RanFang66/SeekCytometer-vivado/constraints/debug_core.xdc

create_debug_core u_ila_0 ila
set_property ALL_PROBE_SAME_MU true [get_debug_cores u_ila_0]
set_property ALL_PROBE_SAME_MU_CNT 2 [get_debug_cores u_ila_0]
set_property C_ADV_TRIGGER false [get_debug_cores u_ila_0]
set_property C_DATA_DEPTH 4096 [get_debug_cores u_ila_0]
set_property C_EN_STRG_QUAL true [get_debug_cores u_ila_0]
set_property C_INPUT_PIPE_STAGES 0 [get_debug_cores u_ila_0]
set_property C_TRIGIN_EN false [get_debug_cores u_ila_0]
set_property C_TRIGOUT_EN false [get_debug_cores u_ila_0]
set_property port_width 1 [get_debug_ports u_ila_0/clk]
connect_debug_port u_ila_0/clk [get_nets [list cytometer_platform_i/zynq_ultra_ps_e_0/inst/pl_clk0]]
set_property PROBE_TYPE DATA_AND_TRIGGER [get_debug_ports u_ila_0/probe0]
set_property port_width 24 [get_debug_ports u_ila_0/probe0]
connect_debug_port u_ila_0/probe0 [get_nets [list {cytometer_platform_i/signal_analyzer_0/inst/signal_analyzer_v1_0_S00_AXI_inst/BASELINE_ESTIMATORS[1].baseline_estimator_inst/baseline[0]} {cytometer_platform_i/signal_analyzer_0/inst/signal_analyzer_v1_0_S00_AXI_inst/BASELINE_ESTIMATORS[1].baseline_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
create_debug_port u_ila_0 probe
set_property PROBE_TYPE DATA_AND_TRIGGER [get_debug_ports u_ila_0/probe1]
set_property port_width 18 [get_debug_ports u_ila_0/probe1]
connect_debug_port u_ila_0/probe1 [get_nets [list {cytometer_platform_i/signal_analyzer_0/inst/signal_analyzer_v1_0_S00_AXI_inst/BASELINE_ESTIMATORS[1].baseline_estimator_inst/baseline_out[0]} {cytometer_platform_i/signal_analyzer_0/inst/signal_analyzer_v1_0_S00_AXI_inst/BASELINE_ESTIMATORS[1].baseline_estimator_inst/baseline_out[1]} {cytometer_platform_i/signal_analyzer_0/inst/signal_analyzer_v1_0_S00_AXI_inst/BASELINE_ESTIMATORS[1].baseline_estimator_inst/baseline_out[2]} {cytometer_platform_i/signal_analyzer_0/inst/signal_analyzer_v1_0_S00_AXI_inst/BASELINE_ESTIMATORS[1].baseline_estimator_inst/baseline_out[3]} {cytometer_platform_i/signal_analyzer_0/inst/signal_analyzer_v1_0_S00_AXI_inst/BASELINE_ESTIMATORS[1].baseline_estimator_inst/baseline_out[4]} {cytometer_platform_i/signal_analyzer_0/inst/signal_analyzer_v1_0_S00_AXI_inst/BASELINE_ESTIMATORS[1].baseline_estimator_inst/baseline_out[5]} {cytometer_platform_i/signal_analyzer_0/inst/signal_analyzer_v1_0_S00_AXI_inst/BASELINE_ESTIMATORS[1].baseline_estimator_inst/baseline_out[6]} {cytometer_platform_i/signal_analyzer_0/inst/signal_analyzer_v1_0_S00_AXI_inst/BASELINE_ESTIMATORS[1].baseline_estimator_inst/baseline_out[7]} {cytometer_platform_i/signal_analyzer_0/inst/signal_analyzer_v1_0_S00_AXI_inst/BASELINE_ESTIMATORS[1].baseline_estimator_inst/baseline_out[8]} {cytometer_platform_i/signal_analyzer_0/inst/signal_analyzer_v1_0_S00_AXI_inst/BASELINE_ESTIMATORS[1].baseline_estimator_inst/baseline_out[9]} {cytometer_platform_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
nst/signal_analyzer_v1_0_S00_AXI_inst/BASELINE_ESTIMATORS[1].baseline_estimator_inst/err_reg[21]} {cytometer_platform_i/signal_analyzer_0/inst/signal_analyzer_v1_0_S00_AXI_inst/BASELINE_ESTIMATORS[1].baseline_estimator_inst/err_reg[22]} {cytometer_platform_i/signal_analyzer_0/inst/signal_analyzer_v1_0_S00_AXI_inst/BASELINE_ESTIMATORS[1].baseline_estimator_inst/err_reg[23]} {cytometer_platform_i/signal_analyzer_0/inst/signal_analyzer_v1_0_S00_AXI_inst/BASELINE_ESTIMATORS[1].baseline_estimator_inst/err_reg[24]}]]
create_debug_port u_ila_0 probe
set_property PROBE_TYPE DATA_AND_TRIGGER [get_debug_ports u_ila_0/probe3]
set_property port_width 18 [get_debug_ports u_ila_0/probe3]
connect_debug_port u_ila_0/probe3 [get_nets [list {cytometer_platform_i/signal_analyzer_0/inst/signal_analyzer_v1_0_S00_AXI_inst/BASELINE_ESTIMATORS[1].baseline_estimator_inst/sample_in[0]} {cytometer_platform_i/signal_analyzer_0/inst/signal_analyzer_v1_0_S00_AXI_inst/BASELINE_ESTIMATORS[1].baseline_estimator_inst/sample_in[1]} {cytometer_platform_i/signal_analyzer_0/inst/signal_analyzer_v1_0_S00_AXI_inst/BASELINE_ESTIMATORS[1].baseline_estimator_inst/sample_in[2]} {cytometer_platform_i/signal_analyzer_0/inst/signal_analyzer_v1_0_S00_AXI_inst/BASELINE_ESTIMATORS[1].baseline_estimator_inst/sample_in[3]} {cytometer_platform_i/signal_analyzer_0/inst/signal_analyzer_v1_0_S00_AXI_inst/BASELINE_ESTIMATORS[1].baseline_estimator_inst/sample_in[4]} {cytometer_platform_i/signal_analyzer_0/inst/signal_analyzer_v1_0_S00_AXI_inst/BASELINE_ESTIMATORS[1].baseline_estimator_inst/sample_in[5]} {cytometer_platform_i/signal_analyzer_0/inst/signal_analyzer_v1_0_S00_AXI_inst/BASELINE_ESTIMATORS[1].baseline_estimator_inst/sample_in[6]} {cytometer_platform_i/signal_analyzer_0/inst/signal_analyzer_v1_0_S00_AXI_inst/BASELINE_ESTIMATORS[1].baseline_estimator_inst/sample_in[7]} {cytometer_platform_i/signal_analyzer_0/inst/signal_analyzer_v1_0_S00_AXI_inst/BASELINE_ESTIMATORS[1].baseline_estimator_inst/sample_in[8]} {cytometer_platform_i/signal_analyzer_0/inst/signal_analyzer_v1_0_S00_AXI_inst/BASELINE_ESTIMATORS[1].baseline_estimator_inst/sample_in[9]} {cytometer_platform_i/signal_analyzer_0/inst/signa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
i/signal_analyzer_0/inst/signal_analyzer_v1_0_S00_AXI_inst/BASELINE_ESTIMATORS[3].baseline_estimator_inst/baseline[21]} {cytometer_platform_i/signal_analyzer_0/inst/signal_analyzer_v1_0_S00_AXI_inst/BASELINE_ESTIMATORS[3].baseline_estimator_inst/baseline[22]} {cytometer_platform_i/signal_analyzer_0/inst/signal_analyzer_v1_0_S00_AXI_inst/BASELINE_ESTIMATORS[3].baseline_estimator_inst/baseline[23]}]]
create_debug_port u_ila_0 probe
set_property PROBE_TYPE DATA_AND_TRIGGER [get_debug_ports u_ila_0/probe6]
set_property port_width 25 [get_debug_ports u_ila_0/probe6]
connect_debug_port u_ila_0/probe6 [get_nets [list {cytometer_platform_i/signal_analyzer_0/inst/signal_analyzer_v1_0_S00_AXI_inst/BASELINE_ESTIMATORS[3].baseline_estimator_inst/err_reg[0]} {cytometer_platform_i/signal_analyzer_0/inst/signal_analyzer_v1_0_S00_AXI_inst/BASELINE_ESTIMATORS[3].baseline_e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
create_debug_port u_ila_0 probe
set_property PROBE_TYPE DATA_AND_TRIGGER [get_debug_ports u_ila_0/probe7]
set_property port_width 18 [get_debug_ports u_ila_0/probe7]
connect_debug_port u_ila_0/probe7 [get_nets [list {cytometer_platform_i/signal_analyzer_0/inst/signal_analyzer_v1_0_S00_AXI_inst/BASELINE_ESTIMATORS[3].baseline_estimator_inst/sample_in[0]} {cytometer_platform_i/signal_analyzer_0/inst/signal_analyzer_v1_0_S00_AXI_inst/BASELINE_ESTIMATORS[3].baseline_estimator_inst/sample_in[1]} {cytometer_platform_i/signal_analyzer_0/inst/signal_analyzer_v1_0_S00_AXI_inst/BASELINE_ESTIMATORS[3].baseline_estimator_inst/sample_in[2]} {cytometer_platform_i/signal_analyzer_0/inst/signal_analyzer_v1_0_S00_AXI_inst/BASELINE_ESTIMATORS[3].baseline_estimator_inst/sample_in[3]} {cytometer_platform_i/signal_analyzer_0/inst/signal_analyzer_v1_0_S00_AXI_inst/BASELINE_ESTIMATORS[3].baseline_estimator_inst/sample_in[4]} {cytometer_platform_i/signal_analyzer_0/inst/signal_analyzer_v1_0_S00_AXI_inst/BASELINE_ESTIMATORS[3].baseline_estimator_inst/sample_in[5]} {cytometer_platform_i/signal_analyzer_0/inst/signal_analyzer_v1_0_S00_AXI_inst/BASELINE_ESTIMATORS[3].baseline_estimator_inst/sample_in[6]} {cytometer_platform_i/signal_analyzer_0/inst/signal_analyzer_v1_0_S00_AXI_inst/BASELINE_ESTIMATORS[3].baseline_estimator_inst/sample_in[7]} {cytometer_platform_i/signal_analyzer_0/inst/signal_analyzer_v1_0_S00_AXI_inst/BASELINE_ESTIMATORS[3].baseline_estimator_inst/sample_in[8]} {cytometer_platform_i/signal_analyzer_0/inst/signal_analyzer_v1_0_S00_AXI_inst/BASELINE_ESTIMATORS[3].baseline_estimator_inst/sample_in[9]} {cytometer_platform_i/signal_analyzer_0/inst/signa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
nst/signal_analyzer_v1_0_S00_AXI_inst/BASELINE_ESTIMATORS[2].baseline_estimator_inst/err_reg[21]} {cytometer_platform_i/signal_analyzer_0/inst/signal_analyzer_v1_0_S00_AXI_inst/BASELINE_ESTIMATORS[2].baseline_estimator_inst/err_reg[22]} {cytometer_platform_i/signal_analyzer_0/inst/signal_analyzer_v1_0_S00_AXI_inst/BASELINE_ESTIMATORS[2].baseline_estimator_inst/err_reg[23]} {cytometer_platform_i/signal_analyzer_0/inst/signal_analyzer_v1_0_S00_AXI_inst/BASELINE_ESTIMATORS[2].baseline_estimator_inst/err_reg[24]}]]
create_debug_port u_ila_0 probe
set_property PROBE_TYPE DATA_AND_TRIGGER [get_debug_ports u_ila_0/probe9]
set_property port_width 24 [get_debug_ports u_ila_0/probe9]
connect_debug_port u_ila_0/probe9 [get_nets [list {cytometer_platform_i/signal_analyzer_0/inst/signal_analyzer_v1_0_S00_AXI_inst/BASELINE_ESTIMATORS[2].baseline_estimator_inst/baseline[0]} {cytometer_platform_i/signal_analyzer_0/inst/signal_analyzer_v1_0_S00_AXI_inst/BASELINE_ESTIMATORS[2].baseline_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
create_debug_port u_ila_0 probe
set_property PROBE_TYPE DATA_AND_TRIGGER [get_debug_ports u_ila_0/probe10]
set_property port_width 18 [get_debug_ports u_ila_0/probe10]
connect_debug_port u_ila_0/probe10 [get_nets [list {cytometer_platform_i/signal_analyzer_0/inst/signal_analyzer_v1_0_S00_AXI_inst/BASELINE_ESTIMATORS[2].baseline_estimator_inst/sample_in[0]} {cytometer_platform_i/signal_analyzer_0/inst/signal_analyzer_v1_0_S00_AXI_inst/BASELINE_ESTIMATORS[2].baseline_estimator_inst/sample_in[1]} {cytometer_platform_i/signal_analyzer_0/inst/signal_analyzer_v1_0_S00_AXI_inst/BASELINE_ESTIMATORS[2].baseline_estimator_inst/sample_in[2]} {cytometer_platform_i/signal_analyzer_0/inst/signal_analyzer_v1_0_S00_AXI_inst/BASELINE_ESTIMATORS[2].baseline_estimator_inst/sample_in[3]} {cytometer_platform_i/signal_analyzer_0/inst/signal_analyzer_v1_0_S00_AXI_inst/BASELINE_ESTIMATORS[2].baseline_estimator_inst/sample_in[4]} {cytometer_platform_i/signal_analyzer_0/inst/signal_analyzer_v1_0_S00_AXI_inst/BASELINE_ESTIMATORS[2].baseline_estimator_inst/sample_in[5]} {cytometer_platform_i/signal_analyzer_0/inst/signal_analyzer_v1_0_S00_AXI_inst/BASELINE_ESTIMATORS[2].baseline_estimator_inst/sample_in[6]} {cytometer_platform_i/signal_analyzer_0/inst/signal_analyzer_v1_0_S00_AXI_inst/BASELINE_ESTIMATORS[2].baseline_estimator_inst/sample_in[7]} {cytometer_platform_i/signal_analyzer_0/inst/signal_analyzer_v1_0_S00_AXI_inst/BASELINE_ESTIMATORS[2].baseline_estimator_inst/sample_in[8]} {cytometer_platform_i/signal_analyzer_0/inst/signal_analyzer_v1_0_S00_AXI_inst/BASELINE_ESTIMATORS[2].baseline_estimator_inst/sample_in[9]} {cytometer_platform_i/signal_analyzer_0/inst/sign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
inst/signal_analyzer_v1_0_S00_AXI_inst/BASELINE_ESTIMATORS[0].baseline_estimator_inst/err_reg[21]} {cytometer_platform_i/signal_analyzer_0/inst/signal_analyzer_v1_0_S00_AXI_inst/BASELINE_ESTIMATORS[0].baseline_estimator_inst/err_reg[22]} {cytometer_platform_i/signal_analyzer_0/inst/signal_analyzer_v1_0_S00_AXI_inst/BASELINE_ESTIMATORS[0].baseline_estimator_inst/err_reg[23]} {cytometer_platform_i/signal_analyzer_0/inst/signal_analyzer_v1_0_S00_AXI_inst/BASELINE_ESTIMATORS[0].baseline_estimator_inst/err_reg[24]}]]
create_debug_port u_ila_0 probe
set_property PROBE_TYPE DATA_AND_TRIGGER [get_debug_ports u_ila_0/probe15]
set_property port_width 24 [get_debug_ports u_ila_0/probe15]
connect_debug_port u_ila_0/probe15 [get_nets [list {cytometer_platform_i/signal_analyzer_0/inst/signal_analyzer_v1_0_S00_AXI_inst/BASELINE_ESTIMATORS[0].baseline_estimator_inst/baseline[0]} {cytometer_platform_i/signal_analyzer_0/inst/signal_analyzer_v1_0_S00_AXI_inst/BASELINE_ESTIMATORS[0].baseline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
create_debug_port u_ila_0 probe
set_property PROBE_TYPE DATA_AND_TRIGGER [get_debug_ports u_ila_0/probe16]
set_property port_width 1 [get_debug_ports u_ila_0/probe16]
connect_debug_port u_ila_0/probe16 [get_nets [list {cytometer_platform_i/signal_analyzer_0/inst/signal_analyzer_v1_0_S00_AXI_inst/BASELINE_ESTIMATORS[1].baseline_estimator_inst/baseline_valid}]]
create_debug_port u_ila_0 probe
set_property PROBE_TYPE DATA_AND_TRIGGER [get_debug_ports u_ila_0/probe17]
set_property port_width 1 [get_debug_ports u_ila_0/probe17]
connect_debug_port u_ila_0/probe17 [get_nets [list {cytometer_platform_i/signal_analyzer_0/inst/signal_analyzer_v1_0_S00_AXI_inst/BASELINE_ESTIMATORS[0].baseline_estimator_inst/baseline_valid}]]
create_debug_port u_ila_0 probe
set_property PROBE_TYPE DATA_AND_TRIGGER [get_debug_ports u_ila_0/probe18]
set_property port_width 1 [get_debug_ports u_ila_0/probe18]
connect_debug_port u_ila_0/probe18 [get_nets [list {cytometer_platform_i/signal_analyzer_0/inst/signal_analyzer_v1_0_S00_AXI_inst/BASELINE_ESTIMATORS[2].baseline_estimator_inst/baseline_valid}]]
create_debug_port u_ila_0 probe
set_property PROBE_TYPE DATA_AND_TRIGGER [get_debug_ports u_ila_0/probe19]
set_property port_width 1 [get_debug_ports u_ila_0/probe19]
connect_debug_port u_ila_0/probe19 [get_nets [list {cytometer_platform_i/signal_analyzer_0/inst/signal_analyzer_v1_0_S00_AXI_inst/BASELINE_ESTIMATORS[3].baseline_estimator_inst/baseline_valid}]]
create_debug_port u_ila_0 probe
set_property PROBE_TYPE DATA_AND_TRIGGER [get_debug_ports u_ila_0/probe20]
set_property port_width 1 [get_debug_ports u_ila_0/probe20]
connect_debug_port u_ila_0/probe20 [get_nets [list {cytometer_platform_i/signal_analyzer_0/inst/signal_analyzer_v1_0_S00_AXI_inst/BASELINE_ESTIMATORS[0].baseline_estimator_inst/pulse_active}]]
create_debug_port u_ila_0 probe
set_property PROBE_TYPE DATA_AND_TRIGGER [get_debug_ports u_ila_0/probe21]
set_property port_width 1 [get_debug_ports u_ila_0/probe21]
connect_debug_port u_ila_0/probe21 [get_nets [list {cytometer_platform_i/signal_analyzer_0/inst/signal_analyzer_v1_0_S00_AXI_inst/BASELINE_ESTIMATORS[2].baseline_estimator_inst/pulse_active}]]
create_debug_port u_ila_0 probe
set_property PROBE_TYPE DATA_AND_TRIGGER [get_debug_ports u_ila_0/probe22]
set_property port_width 1 [get_debug_ports u_ila_0/probe22]
connect_debug_port u_ila_0/probe22 [get_nets [list {cytometer_platform_i/signal_analyzer_0/inst/signal_analyzer_v1_0_S00_AXI_inst/BASELINE_ESTIMATORS[1].baseline_estimator_inst/pulse_active}]]
create_debug_port u_ila_0 probe
set_property PROBE_TYPE DATA_AND_TRIGGER [get_debug_ports u_ila_0/probe23]
set_property port_width 1 [get_debug_ports u_ila_0/probe23]
connect_debug_port u_ila_0/probe23 [get_nets [list {cytometer_platform_i/signal_analyzer_0/inst/signal_analyzer_v1_0_S00_AXI_inst/BASELINE_ESTIMATORS[3].baseline_estimator_inst/pulse_active}]]
create_debug_port u_ila_0 probe
set_property PROBE_TYPE DATA_AND_TRIGGER [get_debug_ports u_ila_0/probe24]
set_property port_width 1 [get_debug_ports u_ila_0/probe24]
connect_debug_port u_ila_0/probe24 [get_nets [list {cytometer_platform_i/signal_analyzer_0/inst/signal_analyzer_v1_0_S00_AXI_inst/PULSE_ANALYZERS[3].pulse_analyzer_inst/sample_valid}]]
create_debug_port u_ila_0 probe
set_property PROBE_TYPE DATA_AND_TRIGGER [get_debug_ports u_ila_0/probe25]
set_property port_width 1 [get_debug_ports u_ila_0/probe25]
connect_debug_port u_ila_0/probe25 [get_nets [list {cytometer_platform_i/signal_analyzer_0/inst/signal_analyzer_v1_0_S00_AXI_inst/PULSE_ANALYZERS[0].pulse_analyzer_inst/sample_valid}]]
create_debug_port u_ila_0 probe
set_property PROBE_TYPE DATA_AND_TRIGGER [get_debug_ports u_ila_0/probe26]
set_property port_width 1 [get_debug_ports u_ila_0/probe26]
connect_debug_port u_ila_0/probe26 [get_nets [list {cytometer_platform_i/signal_analyzer_0/inst/signal_analyzer_v1_0_S00_AXI_inst/PULSE_ANALYZERS[1].pulse_analyzer_inst/sample_valid}]]
create_debug_port u_ila_0 probe
set_property PROBE_TYPE DATA_AND_TRIGGER [get_debug_ports u_ila_0/probe27]
set_property port_width 1 [get_debug_ports u_ila_0/probe27]
connect_debug_port u_ila_0/probe27 [get_nets [list {cytometer_platform_i/signal_analyzer_0/inst/signal_analyzer_v1_0_S00_AXI_inst/PULSE_ANALYZERS[2].pulse_analyzer_inst/sample_valid}]]
create_debug_port u_ila_0 probe
set_property PROBE_TYPE DATA_AND_TRIGGER [get_debug_ports u_ila_0/probe28]
set_property port_width 1 [get_debug_ports u_ila_0/probe28]
connect_debug_port u_ila_0/probe28 [get_nets [list {cytometer_platform_i/signal_analyzer_0/inst/signal_analyzer_v1_0_S00_AXI_inst/BASELINE_ESTIMATORS[3].baseline_estimator_inst/state}]]
create_debug_port u_ila_0 probe
set_property PROBE_TYPE DATA_AND_TRIGGER [get_debug_ports u_ila_0/probe29]
set_property port_width 1 [get_debug_ports u_ila_0/probe29]
connect_debug_port u_ila_0/probe29 [get_nets [list {cytometer_platform_i/signal_analyzer_0/inst/signal_analyzer_v1_0_S00_AXI_inst/BASELINE_ESTIMATORS[1].baseline_estimator_inst/state}]]
create_debug_port u_ila_0 probe
set_property PROBE_TYPE DATA_AND_TRIGGER [get_debug_ports u_ila_0/probe30]
set_property port_width 1 [get_debug_ports u_ila_0/probe30]
connect_debug_port u_ila_0/probe30 [get_nets [list {cytometer_platform_i/signal_analyzer_0/inst/signal_analyzer_v1_0_S00_AXI_inst/BASELINE_ESTIMATORS[0].baseline_estimator_inst/state}]]
create_debug_port u_ila_0 probe
set_property PROBE_TYPE DATA_AND_TRIGGER [get_debug_ports u_ila_0/probe31]
set_property port_width 1 [get_debug_ports u_ila_0/probe31]
connect_debug_port u_ila_0/probe31 [get_nets [list {cytometer_platform_i/signal_analyzer_0/inst/signal_analyzer_v1_0_S00_AXI_inst/BASELINE_ESTIMATORS[2].baseline_estimator_inst/state}]]
set_property C_CLK_INPUT_FREQ_HZ 300000000 [get_debug_cores dbg_hub]
set_property C_ENABLE_CLK_DIVIDER false [get_debug_cores dbg_hub]
set_property C_USER_SCAN_CHAIN 1 [get_debug_cores dbg_hub]
connect_debug_port dbg_hub/clk [get_nets u_ila_0_pl_clk0]
