RanFang66/SeekCytometer-vivado/ip_repo/signal_analyzer_1_0/hdl/signal_analyzer_v1_0_S00_AXI.v

`timescale 1 ns / 1 ps

	module signal_analyzer_v1_0_S00_AXI #
	(
		// Users to add parameters here
        parameter integer  C_AD_DATA_DEPTH = 18,
        parameter integer  C_AD_CHANNEL_NUM = 8,
		// User parameters ends
		// Do not modify the parameters beyond this line

		// Width of S_AXI data bus
		parameter integer C_S_AXI_DATA_WIDTH	= 32,
		// Width of S_AXI address bus
		parameter integer C_S_AXI_ADDR_WIDTH	= 8
	)
	(
		// Users to add ports here
		input wire ad_data_valid,
        input wire [C_AD_DATA_DEPTH-1:0] ad_ch1_val,
        input wire [C_AD_DATA_DEPTH-1:0] ad_ch2_val,
        input wire [C_AD_DATA_DEPTH-1:0] ad_ch3_val,
        input wire [C_AD_DATA_DEPTH-1:0] ad_ch4_val,
        input wire [C_AD_DATA_DEPTH-1:0] ad_ch5_val,
        input wire [C_AD_DATA_DEPTH-1:0] ad_ch6_val,
        input wire [C_AD_DATA_DEPTH-1:0] ad_ch7_val,
        input wire [C_AD_DATA_DEPTH-1:0] ad_ch8_val,
        
        output wire event_active,
		output wire [C_AD_CHANNEL_NUM-1:0] channel_active,
		output wire event_done,
		output wire [2:0] drive_state_out,
		output wire drive_level_out,

		output wire [31:0] bram_din_a, // Data to write to BRAM
		output wire [31:0] bram_addr_a, // Address in BRAM
		output wire bram_we_a, // Write enable for BRAM
		output wire bram_en_a, // Enable signal for BRAM

        output wire [31:0] bram_din_b,        // Data to write to BRAM
		output wire [31:0] bram_addr_b, // Address in BRAM
		output wire [3:0] bram_we_b,            // Write enable for BRAM
		output wire bram_en_b,            // Enable signal for BRAM
		input  wire [31:0] bram_dout_b,       // Data read from BRAM, not used in this module
		output wire bram_rst_b,          // Reset signal for BRAM
		output wire bram_clk_b,          // Clock signal for BRAM

		// User ports ends
		// Do not modify the ports beyond this line

		// Global Clock Signal
		input wire  S_AXI_ACLK,
		// Global Reset Signal. This Signal is Active LOW
		input wire  S_AXI_ARESETN,
		// Write address (issued by master, acceped by Slave)
		input wire [C_S_AXI_ADDR_WIDTH-1 : 0] S_AXI_AWADDR,
		// Write channel Protection type. This signal indicates the
    		// privilege and security level of the transaction, and whether
    		// the transaction is a data access or an instruction access.
		input wire [2 : 0] S_AXI_AWPROT,
		// Write address valid. This signal indicates that the master signaling
    		// valid write address and control information.
		input wire  S_AXI_AWVALID,
		// Write address ready. This signal indicates that the slave is ready
    		// to accept an address and associated control signals.
		output wire  S_AXI_AWREADY,
		// Write data (issued by master, acceped by Slave) 
		input wire [C_S_AXI_DATA_WIDTH-1 : 0] S_AXI_WDATA,
		// Write strobes. This signal indicates which byte lanes hold
    		// valid data. There is one write strobe bit for each eight
    		// bits of the write data bus.    
		input wire [(C_S_AXI_DATA_WIDTH/8)-1 : 0] S_AXI_WSTRB,
		// Write valid. This signal indicates that valid write
    		// data and strobes are available.
		input wire  S_AXI_WVALID,
		// Write ready. This signal indicates that the slave
    		// can accept the write data.
		output wire  S_AXI_WREADY,
		// Write response. This signal indicates the status
    		// of the write transaction.
		output wire [1 : 0] S_AXI_BRESP,
		// Write response valid. This signal indicates that the channel
    		// is signaling a valid write response.
		output wire  S_AXI_BVALID,
		// Response ready. This signal indicates that the master
    		// can accept a write response.
		input wire  S_AXI_BREADY,
		// Read address (issued by master, acceped by Slave)
		input wire [C_S_AXI_ADDR_WIDTH-1 : 0] S_AXI_ARADDR,
		// Protection type. This signal indicates the privilege
    		// and security level of the transaction, and whether the
    		// transaction is a data access or an instruction access.
		input wire [2 : 0] S_AXI_ARPROT,
		// Read address valid. This signal indicates that the channel
    		// is signaling valid read address and control information.
		input wire  S_AXI_ARVALID,
		// Read address ready. This signal indicates that the slave is
    		// ready to accept an address and associated control signals.
		output wire  S_AXI_ARREADY,
		// Read data (issued by slave)
		output wire [C_S_AXI_DATA_WIDTH-1 : 0] S_AXI_RDATA,
		// Read response. This signal indicates the status of the
    		// read transfer.
		output wire [1 : 0] S_AXI_RRESP,
		// Read valid. This signal indicates that the channel is
    		// signaling the required read data.
		output wire  S_AXI_RVALID,
		// Read ready. This signal indicates that the master can
    		// accept the read data and response information.
		input wire  S_AXI_RREADY
	);
    
   
        



	// AXI4LITE signals
	reg [C_S_AXI_ADDR_WIDTH-1 : 0] 	axi_awaddr;
	reg  	axi_awready;
	reg  	axi_wready;
	reg [1 : 0] 	axi_bresp;
	reg  	axi_bvalid;
	reg [C_S_AXI_ADDR_WIDTH-1 : 0] 	axi_araddr;
	reg  	axi_arready;
	reg [C_S_AXI_DATA_WIDTH-1 : 0] 	axi_rdata;
	reg [1 : 0] 	axi_rresp;
	reg  	axi_rvalid;

	// Example-specific design signals
	// local parameter for addressing 32 bit / 64 bit C_S_AXI_DATA_WIDTH
	// ADDR_LSB is used for addressing 32/64 bit registers/memories
	// ADDR_LSB = 2 for 32 bits (n downto 2)
	// ADDR_LSB = 3 for 64 bits (n downto 3)
	localparam integer ADDR_LSB = (C_S_AXI_DATA_WIDTH/32) + 1;
	localparam integer OPT_MEM_ADDR_BITS = 5;
	//----------------------------------------------
	//-- Signals for user logic register space example
	//------------------------------------------------
	//-- Number of Slave Registers 64
	reg [C_S_AXI_DATA_WIDTH-1:0]	slv_reg0;
	reg [C_S_AXI_DATA_WIDTH-1:0]	slv_reg1;
	reg [C_S_AXI_DATA_WIDTH-1:0]	slv_reg2;
	reg [C_S_AXI_DATA_WIDTH-1:0]	slv_reg3;
	reg [C_S_AXI_DATA_WIDTH-1:0]	slv_reg4;
	reg [C_S_AXI_DATA_WIDTH-1:0]	slv_reg5;
	reg [C_S_AXI_DATA_WIDTH-1:0]	slv_reg6;
	reg [C_S_AXI_DATA_WIDTH-1:0]	slv_reg7;
	reg [C_S_AXI_DATA_WIDTH-1:0]	slv_reg8;
	reg [C_S_AXI_DATA_WIDTH-1:0]	slv_reg9;
	reg [C_S_AXI_DATA_WIDTH-1:0]	slv_reg10;
	reg [C_S_AXI_DATA_WIDTH-1:0]	slv_reg11;
	reg [C_S_AXI_DATA_WIDTH-1:0]	slv_reg12;
	reg [C_S_AXI_DATA_WIDTH-1:0]	slv_reg13;
	reg [C_S_AXI_DATA_WIDTH-1:0]	slv_reg14;
	reg [C_S_AXI_DATA_WIDTH-1:0]	slv_reg15;
	reg [C_S_AXI_DATA_WIDTH-1:0]	slv_reg16;
	reg [C_S_AXI_DATA_WIDTH-1:0]	slv_reg17;
	reg [C_S_AXI_DATA_WIDTH-1:0]	slv_reg18;
	reg [C_S_AXI_DATA_WIDTH-1:0]	slv_reg19;
	reg [C_S_AXI_DATA_WIDTH-1:0]	slv_reg20;
	reg [C_S_AXI_DATA_WIDTH-1:0]	slv_reg21;
	reg [C_S_AXI_DATA_WIDTH-1:0]	slv_reg22;
	reg [C_S_AXI_DATA_WIDTH-1:0]	slv_reg23;
	reg [C_S_AXI_DATA_WIDTH-1:0]	slv_reg24;
	reg [C_S_AXI_DATA_WIDTH-1:0]	slv_reg25;
	reg [C_S_AXI_DATA_WIDTH-1:0]	slv_reg26;
	reg [C_S_AXI_DATA_WIDTH-1:0]	slv_reg27;
	reg [C_S_AXI_DATA_WIDTH-1:0]	slv_reg28;
	reg [C_S_AXI_DATA_WIDTH-1:0]	slv_reg29;
	reg [C_S_AXI_DATA_WIDTH-1:0]	slv_reg30;
	reg [C_S_AXI_DATA_WIDTH-1:0]	slv_reg31;
	reg [C_S_AXI_DATA_WIDTH-1:0]	slv_reg32;
	reg [C_S_AXI_DATA_WIDTH-1:0]	slv_reg33;
	reg [C_S_AXI_DATA_WIDTH-1:0]	slv_reg34;
	reg [C_S_AXI_DATA_WIDTH-1:0]	slv_reg35;
	reg [C_S_AXI_DATA_WIDTH-1:0]	slv_reg36;
	reg [C_S_AXI_DATA_WIDTH-1:0]	slv_reg37;
	reg [C_S_AXI_DATA_WIDTH-1:0]	slv_reg38;
	reg [C_S_AXI_DATA_WIDTH-1:0]	slv_reg39;
	reg [C_S_AXI_DATA_WIDTH-1:0]	slv_reg40;
	reg [C_S_AXI_DATA_WIDTH-1:0]	slv_reg41;
	reg [C_S_AXI_DATA_WIDTH-1:0]	slv_reg42;
	reg [C_S_AXI_DATA_WIDTH-1:0]	slv_reg44;
	reg [C_S_AXI_DATA_WIDTH-1:0]	slv_reg45;
	reg [C_S_AXI_DATA_WIDTH-1:0]	slv_reg46;
	reg [C_S_AXI_DATA_WIDTH-1:0]	slv_reg47;
	reg [C_S_AXI_DATA_WIDTH-1:0]	slv_reg48;
	reg [C_S_AXI_DATA_WIDTH-1:0]	slv_reg49;
	reg [C_S_AXI_DATA_WIDTH-1:0]	slv_reg50;
	reg [C_S_AXI_DATA_WIDTH-1:0]	slv_reg51;
	reg [C_S_AXI_DATA_WIDTH-1:0]	slv_reg52;
	reg [C_S_AXI_DATA_WIDTH-1:0]	slv_reg53;
	reg [C_S_AXI_DATA_WIDTH-1:0]	slv_reg54;
	reg [C_S_AXI_DATA_WIDTH-1:0]	slv_reg56;
	reg [C_S_AXI_DATA_WIDTH-1:0]	slv_reg57;
	reg [C_S_AXI_DATA_WIDTH-1:0]	slv_reg58;
	reg [C_S_AXI_DATA_WIDTH-1:0]	slv_reg59;
	reg [C_S_AXI_DATA_WIDTH-1:0]	slv_reg60;
	reg [C_S_AXI_DATA_WIDTH-1:0]	slv_reg61;
	reg [C_S_AXI_DATA_WIDTH-1:0]	slv_reg62;
	reg [C_S_AXI_DATA_WIDTH-1:0]	slv_reg63;
	wire	 slv_reg_rden;
	wire	 slv_reg_wren;
	reg [C_S_AXI_DATA_WIDTH-1:0]	 reg_data_out;
	integer	 byte_index;
	reg	 aw_en;

	// I/O Connections assignments
	wire  [31:0] last_written_addr;
	wire  wrap_around;
	assign S_AXI_AWREADY	= axi_awready;
	assign S_AXI_WREADY	= axi_wready;
	assign S_AXI_BRESP	= axi_bresp;
	assign S_AXI_BVALID	= axi_bvalid;
	assign S_AXI_ARREADY	= axi_arready;
	assign S_AXI_RDATA	= axi_rdata;
	assign S_AXI_RRESP	= axi_rresp;
	assign S_AXI_RVALID	= axi_rvalid;

 // User definitions
    wire [C_AD_CHANNEL_NUM-1:0] enabled_channels = slv_reg1[C_AD_CHANNEL_NUM-1:0];

	// Threshold values for each channel
	wire [C_AD_DATA_DEPTH-1:0] threshold_value[C_AD_CHANNEL_NUM-1:0];


	// Assign threshold values from slave registers
	assign threshold_value[0] = slv_reg8[(C_AD_DATA_DEPTH-1):0];
	assign threshold_value[1] = slv_reg9[(C_AD_DATA_DEPTH-1):0];
	assign threshold_value[2] = slv_reg10[(C_AD_DATA_DEPTH-1):0];
	assign threshold_value[3] = slv_reg11[(C_AD_DATA_DEPTH-1):0];
	assign threshold_value[4] = slv_reg12[(C_AD_DATA_DEPTH-1):0];
	assign threshold_value[5] = slv_reg13[(C_AD_DATA_DEPTH-1):0];
	assign threshold_value[6] = slv_reg14[(C_AD_DATA_DEPTH-1):0];
	assign threshold_value[7] = slv_reg15[(C_AD_DATA_DEPTH-1):0];

	// Assign ADC data to an array for easier access
	wire signed [C_AD_DATA_DEPTH-1:0]  ad_data_array [C_AD_CHANNEL_NUM-1:0];


	// Pulse detection results per channel
	wire [15:0] pulse_width [C_AD_CHANNEL_NUM-1:0];
	wire signed [C_AD_DATA_DEPTH-1:0] pulse_peak [C_AD_CHANNEL_NUM-1:0];
	wire signed [31:0] pulse_area [C_AD_CHANNEL_NUM-1:0];
	wire [63:0] peak_time [C_AD_CHANNEL_NUM-1:0];
	wire [C_AD_CHANNEL_NUM-1:0] pulse_active;
	wire [C_AD_CHANNEL_NUM-1:0] pulse_done;

	wire signed [C_AD_DATA_DEPTH-1:0] baseline_out [C_AD_CHANNEL_NUM-1:0];
	wire [C_AD_CHANNEL_NUM-1:0] baseline_valid;
	wire [C_AD_CHANNEL_NUM-1:0] baseline_overflow; // per-channel "pulse wider than max_pulse_wid"

	// Baseline correction enable (slv_reg2[0]). When 0, pulse_analyzer falls back
	// to absolute threshold + raw metrics (effective baseline forced 0 / valid 0).
	// The estimator keeps running in background so re-enabling is glitch-free.
	wire baseline_en = slv_reg2[0];

	// Baseline monitor readback (slv_reg42[2:0] selects channel, slv_reg43 reads)
	wire [2:0] mon_ch = slv_reg42[2:0];
	wire signed [C_AD_DATA_DEPTH-1:0] baseline_mon = baseline_out[mon_ch];
	wire baseline_valid_mon = baseline_valid[mon_ch];

	// Any channel currently reporting an over-wide pulse (slv_reg44[9]).
	wire baseline_overflow_any = |baseline_overflow;

	wire signed [C_AD_CHANNEL_NUM*18-1:0] ch_peak_flat;
	wire signed [C_AD_CHANNEL_NUM*32-1:0] ch_area_flat;
	wire [C_AD_CHANNEL_NUM*16-1:0] ch_width_flat;
	wire [C_AD_CHANNEL_NUM*64-1:0] ch_peak_time_flat;
	genvar gi;
	generate
		for (gi = 0; gi < C_AD_CHANNEL_NUM; gi = gi + 1) begin
			assign ch_peak_flat[gi*18 +: 18] = pulse_peak[gi];
			assign ch_area_flat[gi*32 +: 32] = pulse_area[gi];
			assign ch_width_flat[gi*16 +: 16] = pulse_width[gi];
			assign ch_peak_time_flat[gi*64 +: 64] = peak_time[gi];	
		end
	endgenerate


	reg  analyze_en;
	reg  sort_en;
	reg  speed_measure_en;
	reg  delay_refer_en;

	reg  ad_data_valid_d0;
	reg  ad_data_valid_d1;

	wire  [31:0] event_counter;

	wire ad_data_updated = !ad_data_valid_d1 && ad_data_valid_d0; // Rising edge of ADC data valid

	// Speed measurement channel selection
	wire [2:0] speed_pre;
	wire [2:0] speed_post;
	wire signed [31:0] dist;
	wire [31:0]	max_time_diff;

	// Delay reference channel selection (from slv_reg52[18:16])
	wire [2:0] delay_refer_ch;

	assign channel_active = pulse_active;
	// User definitions end

	// Implement axi_awready generation
	// axi_awready is asserted for one S_AXI_ACLK clock cycle when both
	// S_AXI_AWVALID and S_AXI_WVALID are asserted. axi_awready is
	// de-asserted when reset is low.

	always @( posedge S_AXI_ACLK )
	begin
	  if ( S_AXI_ARESETN == 1'b0 )
	    begin
	      axi_awready <= 1'b0;
	      aw_en <= 1'b1;
	    end 
	  else
	    begin    
	      if (~axi_awready && S_AXI_AWVALID && S_AXI_WVALID && aw_en)
	        begin
	          // slave is ready to accept write address when 
	          // there is a valid write address and write data
	          // on the write address and data bus. This design 
	          // expects no outstanding transactions. 
	          axi_awready <= 1'b1;
	          aw_en <= 1'b0;
	        end
	        else if (S_AXI_BREADY && axi_bvalid)
	            begin
	              aw_en <= 1'b1;
	              axi_awready <= 1'b0;
	            end
	      else           
	        begin
	          axi_awready <= 1'b0;
	        end
	    end 
	end       

	// Implement axi_awaddr latching
	// This process is used to latch the address when both 
	// S_AXI_AWVALID and S_AXI_WVALID are valid. 

	always @( posedge S_AXI_ACLK )
	begin
	  if ( S_AXI_ARESETN == 1'b0 )
	    begin
	      axi_awaddr <= 0;
	    end 
	  else
	    begin    
	      if (~axi_awready && S_AXI_AWVALID && S_AXI_WVALID && aw_en)
	        begin
	          // Write Address latching 
	          axi_awaddr <= S_AXI_AWADDR;
	        end
	    end 
	end       

	// Implement axi_wready generation
	// axi_wready is asserted for one S_AXI_ACLK clock cycle when both
	// S_AXI_AWVALID and S_AXI_WVALID are asserted. axi_wready is 
	// de-asserted when reset is low. 

	always @( posedge S_AXI_ACLK )
	begin
	  if ( S_AXI_ARESETN == 1'b0 )
	    begin
	      axi_wready <= 1'b0;
	    end 
	  else
	    begin    
	      if (~axi_wready && S_AXI_WVALID && S_AXI_AWVALID && aw_en )
	        begin
	          // slave is ready to accept write data when 
	          // there is a valid write address and write data
	          // on the write address and data bus. This design 
	          // expects no outstanding transactions. 
	          axi_wready <= 1'b1;
	        end
	      else
	        begin
	          axi_wready <= 1'b0;
	        end
	    end 
	end       

	// Implement memory mapped register select and write logic generation
	// The write data is accepted and written to memory mapped registers when
	// axi_awready, S_AXI_WVALID, axi_wready and S_AXI_WVALID are asserted. Write strobes are used to
	// select byte enables of slave registers while writing.
	// These registers are cleared when reset (active low) is applied.
	// Slave register write enable is asserted when valid address and data are available
	// and the slave is ready to accept the write address and write data.
	assign slv_reg_wren = axi_wready && S_AXI_WVALID && axi_awready && S_AXI_AWVALID;

	always @( posedge S_AXI_ACLK )
	begin
	  if ( S_AXI_ARESETN == 1'b0 )
	    begin
	      slv_reg0 <= 0;
	      slv_reg1 <= 0;
	      slv_reg2 <= 32'h00000040; // default alpha_shift[6:2] = 16 (slow up-leg; see baseline_estimator.v)
	      slv_reg3 <= 32'h00080400; // default: guard_len=8, acquire_len=1024
	      slv_reg4 <= 32'd4095; // default: max_pulse_wid=4095 (~4 ms @1 MSPS; must exceed the widest real pulse)
	      slv_reg5 <= 0;
	      slv_reg6 <= 0;
	      slv_reg7 <= 0;
	      slv_reg8 <= 0;
	      slv_reg9 <= 0;
	      slv_reg10 <= 0;
	      slv_reg11 <= 0;
	      slv_reg12 <= 0;
	      slv_reg13 <= 0;
	      slv_reg14 <= 0;
	      slv_reg15 <= 0;
	      slv_reg16 <= 0;
	      slv_reg17 <= 0;
	      slv_reg18 <= 0;
	      slv_reg19 <= 0;
	      slv_reg20 <= 0;
	      slv_reg21 <= 0;
	      slv_reg22 <= 0;
	      slv_reg23 <= 0;
	      slv_reg24 <= 0;
	      slv_reg25 <= 0;
	      slv_reg26 <= 0;
	      slv_reg27 <= 0;
	      slv_reg28 <= 0;
	      slv_reg29 <= 0;
	      slv_reg30 <= 0;
	      slv_reg31 <= 0;
	      slv_reg32 <= 0;
	      slv_reg33 <= 0;
	      slv_reg34 <= 0;
	      slv_reg35 <= 0;
	      slv_reg36 <= 0;
	      slv_reg37 <= 0;
	      slv_reg38 <= 0;
	      slv_reg39 <= 0;
	      slv_reg40 <= 0;
	      slv_reg41 <= 0;
	      slv_reg42 <= 0;
	      slv_reg44 <= 0;
	      slv_reg45 <= 0;
	      slv_reg46 <= 0;
	      slv_reg47 <= 0;
	      slv_reg48 <= 0;
	      slv_reg49 <= 0;
	      slv_reg50 <= 0;
	      slv_reg51 <= 0;
	      slv_reg52 <= 0;
	      slv_reg53 <= 0;
	      slv_reg54 <= 0;
	      slv_reg56 <= 0;
	      slv_reg57 <= 0;
	      slv_reg58 <= 0;
	      slv_reg59 <= 0;
	      slv_reg60 <= 0;
	      slv_reg61 <= 0;
	      slv_reg62 <= 0;
	      slv_reg63 <= 0;
	    end 
	  else begin
	    if (slv_reg_wren)
	      begin
	        case ( axi_awaddr[ADDR_LSB+OPT_MEM_ADDR_BITS:ADDR_LSB] )
	          6'h00:
	            for ( byte_index = 0; byte_index <= (C_S_AXI_DATA_WIDTH/8)-1; byte_index = byte_index+1 )
	              if ( S_AXI_WSTRB[byte_index] == 1 ) begin
	                // Respective byte enables are asserted as per write strobes 
	                // Slave register 0
	                slv_reg0[(byte_index*8) +: 8] <= S_AXI_WDATA[(byte_index*8) +: 8];
	              end  
	          6'h01:
	            for ( byte_index = 0; byte_index <= (C_S_AXI_DATA_WIDTH/8)-1; byte_index = byte_index+1 )
	              if ( S_AXI_WSTRB[byte_index] == 1 ) begin
	                // Respective byte enables are asserted as per write strobes 
	                // Slave register 1
	                slv_reg1[(byte_index*8) +: 8] <= S_AXI_WDATA[(byte_index*8) +: 8];
	              end  
	          6'h02:
	            for ( byte_index = 0; byte_index <= (C_S_AXI_DATA_WIDTH/8)-1; byte_index = byte_index+1 )
	              if ( S_AXI_WSTRB[byte_index] == 1 ) begin
	                // Respective byte enables are asserted as per write strobes 
	                // Slave register 2
	                slv_reg2[(byte_index*8) +: 8] <= S_AXI_WDATA[(byte_index*8) +: 8];
	              end  
	          6'h03:
	            for ( byte_index = 0; byte_index <= (C_S_AXI_DATA_WIDTH/8)-1; byte_index = byte_index+1 )
	              if ( S_AXI_WSTRB[byte_index] == 1 ) begin
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
	                      slv_reg21 <= slv_reg21;
	                      slv_reg22 <= slv_reg22;
	                      slv_reg23 <= slv_reg23;
	                      slv_reg24 <= slv_reg24;
	                      slv_reg25 <= slv_reg25;
	                      slv_reg26 <= slv_reg26;
	                      slv_reg27 <= slv_reg27;
	                      slv_reg28 <= slv_reg28;
	                      slv_reg29 <= slv_reg29;
	                      slv_reg30 <= slv_reg30;
	                      slv_reg31 <= slv_reg31;
	                      slv_reg32 <= slv_reg32;
	                      slv_reg33 <= slv_reg33;
	                      slv_reg34 <= slv_reg34;
	                      slv_reg35 <= slv_reg35;
	                      slv_reg36 <= slv_reg36;
	                      slv_reg37 <= slv_reg37;
	                      slv_reg38 <= slv_reg38;
	                      slv_reg39 <= slv_reg39;
	                      slv_reg40 <= slv_reg40;
	                      slv_reg41 <= slv_reg41;
	                      slv_reg42 <= slv_reg42;
	                      slv_reg44 <= slv_reg44;
	                      slv_reg45 <= slv_reg45;
	                      slv_reg46 <= slv_reg46;
	                      slv_reg47 <= slv_reg47;
	                      slv_reg48 <= slv_reg48;
	                      slv_reg49 <= slv_reg49;
	                      slv_reg50 <= slv_reg50;
	                      slv_reg51 <= slv_reg51;
	                      slv_reg52 <= slv_reg52;
	                      slv_reg53 <= slv_reg53;
	                      slv_reg54 <= slv_reg54;
	                      slv_reg56 <= slv_reg56;
	                      slv_reg57 <= slv_reg57;
	                      slv_reg58 <= slv_reg58;
	                      slv_reg59 <= slv_reg59;
	                      slv_reg60 <= slv_reg60;
	                      slv_reg61 <= slv_reg61;
	                      slv_reg62 <= slv_reg62;
	                      slv_reg63 <= slv_reg63;
	                    end
	        endcase
	      end
	  end
	end    

	// Implement write response logic generation
	// The write response and response valid signals are asserted by the slave 
	// when axi_wready, S_AXI_WVALID, axi_wready and S_AXI_WVALID are asserted.  
	// This marks the acceptance of address and indicates the status of 
	// write transaction.

	always @( posedge S_AXI_ACLK )
	begin
	  if ( S_AXI_ARESETN == 1'b0 )
	    begin
	      axi_bvalid  <= 0;
	      axi_bresp   <= 2'b0;
	    end 
	  else
	    begin    
	      if (axi_awready && S_AXI_AWVALID && ~axi_bvalid && axi_wready && S_AXI_WVALID)
	        begin
	          // indicates a valid write response is available
	          axi_bvalid <= 1'b1;
	          axi_bresp  <= 2'b0; // 'OKAY' response 
	        end                   // work error responses in future
	      else
	        begin
	          if (S_AXI_BREADY && axi_bvalid) 
	            //check if bready is asserted while bvalid is high) 
	            //(there is a possibility that bready is always asserted high)   
	            begin
	              axi_bvalid <= 1'b0; 
	            end  
	        end
	    end
	end   

	// Implement axi_arready generation
	// axi_arready is asserted for one S_AXI_ACLK clock cycle when
	// S_AXI_ARVALID is asserted. axi_awready is 
	// de-asserted when reset (active low) is asserted. 
	// The read address is also latched when S_AXI_ARVALID is 
	// asserted. axi_araddr is reset to zero on reset assertion.

	always @( posedge S_AXI_ACLK )
	begin
	  if ( S_AXI_ARESETN == 1'b0 )
	    begin
	      axi_arready <= 1'b0;
	      axi_araddr  <= 32'b0;
	    end 
	  else
	    begin    
	      if (~axi_arready && S_AXI_ARVALID)
	        begin
	          // indicates that the slave has acceped the valid read address
	          axi_arready <= 1'b1;
	          // Read address latching
	          axi_araddr  <= S_AXI_ARADDR;
	        end
	      else
	        begin
	          axi_arready <= 1'b0;
	        end
	    end 
	end       

	// Implement axi_arvalid generation
	// axi_rvalid is asserted for one S_AXI_ACLK clock cycle when both 
	// S_AXI_ARVALID and axi_arready are asserted. The slave registers 
	// data are available on the axi_rdata bus at this instance. The 
	// assertion of axi_rvalid marks the validity of read data on the 
	// bus and axi_rresp indicates the status of read transaction.axi_rvalid 
	// is deasserted on reset (active low). axi_rresp and axi_rdata are 
	// cleared to zero on reset (active low).  
	always @( posedge S_AXI_ACLK )
	begin
	  if ( S_AXI_ARESETN == 1'b0 )
	    begin
	      axi_rvalid <= 0;
	      axi_rresp  <= 0;
	    end 
	  else
	    begin    
	      if (axi_arready && S_AXI_ARVALID && ~axi_rvalid)
	        begin
	          // Valid read data is available at the read data bus
	          axi_rvalid <= 1'b1;
	          axi_rresp  <= 2'b0; // 'OKAY' response
	        end   
	      else if (axi_rvalid && S_AXI_RREADY)
	        begin
	          // Read data is accepted by the master
	          axi_rvalid <= 1'b0;
	        end                
	    end
	end    

	// Implement memory mapped register select and read logic generation
	// Slave register read enable is asserted when valid address is available
	// and the slave is ready to accept the read address.
	assign slv_reg_rden = axi_arready & S_AXI_ARVALID & ~axi_rvalid;
	always @(*)
	begin
	      // Address decoding for reading registers
	      case ( axi_araddr[ADDR_LSB+OPT_MEM_ADDR_BITS:ADDR_LSB] )
	        6'h00   : reg_data_out <= slv_reg0;
	        6'h01   : reg_data_out <= slv_reg1;
	        6'h02   : reg_data_out <= slv_reg2;
	        6'h03   : reg_data_out <= slv_reg3;
	        6'h04   : reg_data_out <= slv_reg4;
	        6'h05   : reg_data_out <= slv_reg5;
	        6'h06   : reg_data_out <= slv_reg6;
	        6'h07   : reg_data_out <= slv_reg7;
	        6'h08   : reg_data_out <= slv_reg8;
	        6'h09   : reg_data_out <= slv_reg9;
	        6'h0A   : reg_data_out <= slv_reg10;
	        6'h0B   : reg_data_out <= slv_reg11;
	        6'h0C   : reg_data_out <= slv_reg12;
	        6'h0D   : reg_data_out <= slv_reg13;
	        6'h0E   : reg_data_out <= slv_reg14;
	        6'h0F   : reg_data_out <= slv_reg15;
	        6'h10   : reg_data_out <= slv_reg16;
	        6'h11   : reg_data_out <= slv_reg17;
	        6'h12   : reg_data_out <= slv_reg18;
	        6'h13   : reg_data_out <= slv_reg19;
	        6'h14   : reg_data_out <= slv_reg20;
	        6'h15   : reg_data_out <= slv_reg21;
	        6'h16   : reg_data_out <= slv_reg22;
	        6'h17   : reg_data_out <= slv_reg23;
	        6'h18   : reg_data_out <= slv_reg24;
	        6'h19   : reg_data_out <= slv_reg25;
	        6'h1A   : reg_data_out <= slv_reg26;
	        6'h1B   : reg_data_out <= slv_reg27;
	        6'h1C   : reg_data_out <= slv_reg28;
	        6'h1D   : reg_data_out <= slv_reg29;
	        6'h1E   : reg_data_out <= slv_reg30;
	        6'h1F   : reg_data_out <= slv_reg31;
	        6'h20   : reg_data_out <= slv_reg32;
	        6'h21   : reg_data_out <= slv_reg33;
	        6'h22   : reg_data_out <= slv_reg34;
	        6'h23   : reg_data_out <= slv_reg35;
	        6'h24   : reg_data_out <= slv_reg36;
	        6'h25   : reg_data_out <= slv_reg37;
	        6'h26   : reg_data_out <= slv_reg38;
	        6'h27   : reg_data_out <= slv_reg39;
	        6'h28   : reg_data_out <= slv_reg40;
	        6'h29   : reg_data_out <= slv_reg41;
	        6'h2A   : reg_data_out <= slv_reg42;
	        6'h2B   : reg_data_out <= {{13{1'b0}}, baseline_valid_mon, baseline_mon}; // [18]=valid, [17:0]=baseline
	        6'h2C   : reg_data_out <= {8'hA7, enabled_channels, 6'b0, baseline_overflow_any, analyze_en, pulse_active};
	        	         // [31:24]=0xA7 build tag (identifies the firmware revision),
	        	         // [9]=overflow_any, [8]=analyze_en, [7:0]=pulse_active
	        6'h2D   : reg_data_out <= slv_reg45;
	        6'h2E   : reg_data_out <= slv_reg46;
	        6'h2F   : reg_data_out <= slv_reg47;
	        6'h30   : reg_data_out <= slv_reg48;
	        6'h31   : reg_data_out <= slv_reg49;
	        6'h32   : reg_data_out <= slv_reg50;
	        6'h33   : reg_data_out <= slv_reg51;
	        6'h34   : reg_data_out <= slv_reg52;
	        6'h35   : reg_data_out <= slv_reg53;
	        6'h36   : reg_data_out <= slv_reg54;
	        6'h37   : reg_data_out <= 32'h0; // 原 slv_reg55 诊断寄存器已移除（该地址无写寄存器）
	        6'h38   : reg_data_out <= {{7{1'b0}}, wrap_around, last_written_addr[23:0]};//slv_reg56;
	        6'h39   : reg_data_out <= event_counter;//slv_reg57;
	        6'h3A   : reg_data_out <= slv_reg58;
	        6'h3B   : reg_data_out <= slv_reg59;
	        6'h3C   : reg_data_out <= slv_reg60;
	        6'h3D   : reg_data_out <= slv_reg61;
	        6'h3E   : reg_data_out <= slv_reg62;
	        6'h3F   : reg_data_out <= slv_reg63;
	        default : reg_data_out <= 0;
	      endcase
	end

	// Output register or memory read data
	always @( posedge S_AXI_ACLK )
	begin
	  if ( S_AXI_ARESETN == 1'b0 )
	    begin
	      axi_rdata  <= 0;
	    end 
	  else
	    begin    
	      // When there is a valid read address (S_AXI_ARVALID) with 
	      // acceptance of read address by the slave (axi_arready), 
	      // output the read dada 
	      if (slv_reg_rden)
	        begin
	          axi_rdata <= reg_data_out;     // register read data
	        end   
	    end
	end    

	// Add user logic here
	localparam CLK_COUNT_IN_1US = 199; // For a 200 MHz clock
	

	reg [7:0] timer_count;
	reg [63:0] time_stamp_us;
	reg [2:0] sort_ch_x;
	reg [2:0] sort_ch_y;
	reg [1:0] sort_x_type;
	reg [1:0] sort_y_type;
	reg drive_type;
	reg [31:0] drive_delay;
	reg [31:0] drive_width;
	reg [31:0] cooling_time;
	wire [2:0] drive_state;
	wire drive_level;

	reg [31:0] delay_calcu_coe;

	wire [31:0] time_diff;


    wire [7:0] ch_pulse_valid;
	// AD data filter
	ad_data_filter #(
		.C_AD_DATA_DEPTH(C_AD_DATA_DEPTH),
		.C_AD_CHANNEL_NUM(C_AD_CHANNEL_NUM)
	) u_ad_data_filter (
		.clk(S_AXI_ACLK),
		.rst_n(S_AXI_ARESETN),
		.ad_data_updated(ad_data_updated),
		.ad_ch1_val(ad_ch1_val),
		.ad_ch2_val(ad_ch2_val),
		.ad_ch3_val(ad_ch3_val),
		.ad_ch4_val(ad_ch4_val),
		.ad_ch5_val(ad_ch5_val),
		.ad_ch6_val(ad_ch6_val),
		.ad_ch7_val(ad_ch7_val),
		.ad_ch8_val(ad_ch8_val),

		.ad_ch1_val_filt(ad_data_array[0]),
		.ad_ch2_val_filt(ad_data_array[1]),
		.ad_ch3_val_filt(ad_data_array[2]),
		.ad_ch4_val_filt(ad_data_array[3]),
		.ad_ch5_val_filt(ad_data_array[4]),
		.ad_ch6_val_filt(ad_data_array[5]),
		.ad_ch7_val_filt(ad_data_array[6]),
		.ad_ch8_val_filt(ad_data_array[7])    
	);





	assign drive_state_out = drive_state;
	assign drive_level_out = drive_level;

	// -- Sort coordinate selection (channel + parameter type) --
	wire signed [31:0] sort_compare_value_x;
	wire signed [31:0] sort_compare_value_y;

	assign sort_compare_value_x =
    (sort_x_type == 2'b00) ?  {{(32-C_AD_DATA_DEPTH){pulse_peak[sort_ch_x][C_AD_DATA_DEPTH-1]}}, pulse_peak[sort_ch_x]}:
    (sort_x_type == 2'b01) ? {{16'b0}, pulse_width[sort_ch_x]} :
    (sort_x_type == 2'b10) ? pulse_area[sort_ch_x] :
    32'b0;

	assign sort_compare_value_y =
    (sort_y_type == 2'b00) ? {{(32-C_AD_DATA_DEPTH){pulse_peak[sort_ch_y][C_AD_DATA_DEPTH-1]}}, pulse_peak[sort_ch_y]}:
    (sort_y_type == 2'b01) ? {{16'b0}, pulse_width[sort_ch_y]} :
    (sort_y_type == 2'b10) ? pulse_area[sort_ch_y] :
    32'b0;

	// -- Gate judge pipeline for sorting decision --
	// slv_reg17: [2:0]=gate_type, [7:4]=gate_points_num
	// slv_reg18~29: gate_points_x[0..11]
	// slv_reg30~41: gate_points_y[0..11]
	wire gate_valid_out;
	wire gate_result_out;

	wire [32*12-1:0] gate_points_x_pack = {
		slv_reg29, slv_reg28, slv_reg27, slv_reg26, slv_reg25, slv_reg24,
		slv_reg23, slv_reg22, slv_reg21, slv_reg20, slv_reg19, slv_reg18
	};
	wire [32*12-1:0] gate_points_y_pack = {
		slv_reg41, slv_reg40, slv_reg39, slv_reg38, slv_reg37, slv_reg36,
		slv_reg35, slv_reg34, slv_reg33, slv_reg32, slv_reg31, slv_reg30
	};

//	gate_judge_pipeline #(
//		.C_NUM_MAX_POINTS(12),
//		.C_POINT_DATA_WIDTH(32)
//	) u_gate_judge (
//		.rst_n(S_AXI_ARESETN),
//		.sys_clk(S_AXI_ACLK),
//		.enable(1'b1),
//		.trigger(event_done),
//		.point_x(sort_compare_value_x),
//		.point_y(sort_compare_value_y),
//		.gate_type(slv_reg17[2:0]),
//		.gate_points_num(slv_reg17[7:4]),
//		.gate_points_x_pack(gate_points_x_pack),
//		.gate_points_y_pack(gate_points_y_pack),
//		.valid(gate_valid_out),
//		.result(gate_result_out)
//	);
    hierarchical_gate_wrapper #(
		.C_NUM_MAX_POINTS(12),
		.C_POINT_DATA_WIDTH(32)
	) gate_wrapper (
		.clk(S_AXI_ACLK),
		.rst_n(S_AXI_ARESETN),
		
        .bram_din(bram_din_b),
        .bram_addr(bram_addr_b),
        .bram_we(bram_we_b),
        .bram_en(bram_en_b),
        .bram_dout(bram_dout_b),
        .bram_rst(bram_rst_b),
        .bram_clk(bram_clk_b),
		
//		.enable(sort_en),
        .enable(1'b1),
		
		.trigger_in(event_done),
//        .point_x_in(sort_compare_value_x),
//        .point_y_in(sort_compare_value_y),
        .ch_peak_flat(ch_peak_flat),
		.ch_width_flat(ch_width_flat),
		.ch_area_flat(ch_area_flat),
		
		.bram_error(),
		.valid(gate_valid_out),
		.result(gate_result_out)
	);

	// Latch gate result for sort trigger
	reg sort_ready;

	always @(posedge S_AXI_ACLK or negedge S_AXI_ARESETN) begin
		if (!S_AXI_ARESETN) begin
			sort_ready <= 1'b0;
		end else begin
			if (event_done) begin
				sort_ready <= 1'b0;
			end

			if (gate_valid_out) begin
				sort_ready <= 1'b1;
			end
		end
	end

	wire sort_trig = gate_result_out;
	


	always @(posedge S_AXI_ACLK or negedge S_AXI_ARESETN) begin
		if (!S_AXI_ARESETN) begin
			sort_ch_x <= 3'b0;
			sort_ch_y <= 3'b0;
			sort_x_type <= 2'b0;
			sort_y_type <= 2'b0;
			delay_calcu_coe <= 32'b0;
			drive_type <= 1'b0; // Default drive type
			drive_delay <= 32'b0; // Default drive delay
			drive_width <= 32'd100; // Default drive width
			cooling_time <= 32'd100; // Default cooling time
		end else begin
			sort_ch_x <= slv_reg16[2:0]; // Channel number for X axis sorting
			sort_x_type <= slv_reg16[9:8]; // Type of sorting for X axis
			sort_ch_y <= slv_reg16[18:16]; // Channel number for Y axis sorting
			sort_y_type <= slv_reg16[25:24]; // Type of sorting for Y axis

			drive_type <= slv_reg48[0]; // Drive type: 0 for level, 1 for edge
			drive_delay <= slv_reg49; // Drive delay in micro
			drive_width <= slv_reg50; // Drive width in microseconds
			cooling_time <= slv_reg51; // Cooling time in microseconds
			delay_calcu_coe <= slv_reg47;
		end
	end


	// Get 1us time stamp
	always @(posedge S_AXI_ACLK or negedge S_AXI_ARESETN) begin
		if (!S_AXI_ARESETN) begin
			timer_count <= 8'b0;
			time_stamp_us <= 64'b0;
		end else begin
			if (timer_count == CLK_COUNT_IN_1US) begin
				timer_count <= 8'b0;
				time_stamp_us <= time_stamp_us + 1;
			end else begin
				timer_count <= timer_count + 1;
			end
		end
	end


	wire [63:0] event_peak_time;
	assign speed_pre = slv_reg52[2:0];
	assign speed_post = slv_reg52[10:8];
	assign delay_refer_ch = slv_reg52[18:16];
	assign max_time_diff = slv_reg53[31:0]; // Maximum time difference in us between pre and post signals
	assign dist = slv_reg54[31:0]; // Distance in um for speed measurement
	// Use delay_refer_ch's peak_time as the delay reference; falls back to time_us in
	// drive_signal_generation when delay_refer_en is low.
	assign event_peak_time = peak_time[delay_refer_ch];

	// Enable signals for the analyzer, sorting, and speed measurement
	always @(posedge S_AXI_ACLK or negedge S_AXI_ARESETN) begin
		if (!S_AXI_ARESETN) begin
			analyze_en <= 1'b0;
			sort_en <= 1'b0;
			speed_measure_en <= 1'b0;
			ad_data_valid_d0 <= 1'b0;
			ad_data_valid_d1 <= 1'b0;
		end else begin
			analyze_en <= slv_reg0[0]; // Enable signal for the analyzer
			sort_en <= slv_reg0[1]; // Enable signal for sorting
			speed_measure_en <= slv_reg0[2]; // Enable signal for speed measurement
			delay_refer_en <= slv_reg0[3]; // Enable signal for sort delay reference
			ad_data_valid_d0 <= ad_data_valid; // ADC data valid signal
			ad_data_valid_d1 <= ad_data_valid_d0;
		end
	end



	// Pulse analyzers (one per channel)
	genvar i;
	generate
	  for (i = 0; i < C_AD_CHANNEL_NUM; i = i + 1) begin : PULSE_ANALYZERS
	    pulse_analyzer #(
	      .C_AD_DATA_DEPTH(C_AD_DATA_DEPTH)
		) pulse_analyzer_inst (
			.clk(S_AXI_ACLK),
			.rst_n(S_AXI_ARESETN),
			.time_stamp_in(time_stamp_us),
			.sample_valid(ad_data_updated),
			.sample_in(ad_data_array[i]),
			// While baseline correction is on, refuse to detect pulses until the
			// baseline is trusted. detect_ref falls back to the absolute threshold
			// when baseline_valid=0, but that threshold now carries "peak height
			// above baseline" semantics (a few thousand codes) while the raw DC
			// level can be tens of thousands -- the channel would then look
			// permanently "in pulse", which freezes the baseline and used to trip
			// the watchdog forever. Gating here makes the acquire phase silent and
			// removes that self-lock. With baseline correction off the previous
			// absolute-threshold behaviour is unchanged.
			.enabled((enabled_channels[i] | (speed_pre == i) | (speed_post == i))
			         & analyze_en
			         & (~baseline_en | baseline_valid[i])),
			.threshold_value(threshold_value[i]),
			.baseline_out(baseline_en ? baseline_out[i] : {C_AD_DATA_DEPTH{1'b0}}),
			.baseline_valid(baseline_en & baseline_valid[i]),
			.event_done(event_done),
			.pulse_active(pulse_active[i]),
			.pulse_done(pulse_done[i]),
			.width_out(pulse_width[i]),
			.peak_out(pulse_peak[i]),
			.area_out(pulse_area[i]),
			.peak_time_out(peak_time[i])
	    );
	  end
	endgenerate

	// Baseline estimators (one per channel)
	genvar j;
	generate
	  for (j = 0; j < C_AD_CHANNEL_NUM; j = j + 1) begin : BASELINE_ESTIMATORS
	    baseline_estimator #(
	      .C_AD_DATA_DEPTH(C_AD_DATA_DEPTH)
		) baseline_estimator_inst (
			.clk(S_AXI_ACLK),
			.rst_n(S_AXI_ARESETN),
			// Multi-channel system sampling at ~1 MSPS: one 1 kHz Gaussian pulse is
			// easily > 255 samples "above threshold", and the old 255 default made
			// every real pulse look like a stuck input. 4095 samples (~4 ms) clears
			// any realistic pulse train; PS still overrides it at runtime.
			.sample_valid(ad_data_updated),
			.sample_in(ad_data_array[j]),
			.pulse_active(pulse_active[j]),                        // phase 2: freeze baseline during pulse
			.acquire_force(slv_reg2[1]),
			.bypass(slv_reg2[14]),                                 // self-test: slv_reg2[14]
			.alpha_shift(slv_reg2[6:2]),
			.slope_th({2'b0, slv_reg2[13:8]}),
			.acquire_len(slv_reg3[15:0]),
			.guard_len(slv_reg3[23:16]),
			.max_pulse_wid(slv_reg4[15:0]),
			.baseline_valid(baseline_valid[j]),
			.overflow(baseline_overflow[j]),
			.baseline_out(baseline_out[j])
	    );
	  end
	endgenerate


	// Instance of event aggregator
	event_aggregator #(
		.NUM_CH(C_AD_CHANNEL_NUM)
	) event_aggregator_inst (
		.clk(S_AXI_ACLK),
		.rst_n(S_AXI_ARESETN),

		.analyze_en(analyze_en),
		.enable_mask(enabled_channels),
		.ch_pulse_active(pulse_active),
		.ch_peak_flat(ch_peak_flat),
		.ch_width_flat(ch_width_flat),
		.ch_area_flat(ch_area_flat),
		.ch_peak_time_flat(ch_peak_time_flat),

		.speed_measure_en(speed_measure_en),
		.speed_pre_channel(speed_pre),
		.speed_post_channel(speed_post),
		.max_time_diff(max_time_diff),
		
		.sort_trig(sort_trig),
		.sort_ready(sort_ready),
		.drive_state(drive_state),

		.event_id(event_counter),
		.event_active(event_active),
		.event_done(event_done), // high for one clock cycle when event is done

		.bram_addr_a(bram_addr_a),
		.bram_din_a(bram_din_a),
		.bram_we_a(bram_we_a),
		.bram_en_a(bram_en_a),
		.last_written_addr(last_written_addr),
		.last_wrap_around(wrap_around), 
		.measured_time_diff(time_diff),
		.ch_pulse_valid_latched(ch_pulse_valid)
	);


	// Drive signal generation for sorting
	drive_signal_generation #(
		.SAMPLE_DATA_WIDTH(C_AD_DATA_DEPTH),
		.CHANNEL_NUM(C_AD_CHANNEL_NUM)
	) drive_signal_generation_inst (
		.clk(S_AXI_ACLK),
		.rst_n(S_AXI_ARESETN),
		.sort_en(sort_en),
		.sort_trig(sort_trig),
		.drive_type(drive_type),
		.time_us(time_stamp_us),
		.event_peak_time(event_peak_time),
		.drive_delay(drive_delay),
		.drive_width(drive_width),
		.cooling_time(cooling_time),

		.speed_measure_en(speed_measure_en),
   		.measured_time_diff(time_diff[15:0]),
    	.measured_coe(delay_calcu_coe),

		.delay_refer_en(delay_refer_en),

		.drive_state(drive_state),
		.drive_level(drive_level)
	);
 

	// User logic ends

	endmodule
