RanFang66/SeekCytometer-vivado/ip_repo/signal_analyzer_1_0/hdl/gate_judge_pipeline.v

`timescale 1ns / 1ps
//////////////////////////////////////////////////////////////////////////////////
// Module Name: gate_judge_pipeline
// Description: Resource-efficient gate judgement module with pipelined design.
//              Supports four gate types:
//                1 - Interval gate   (1-D range on X)
//                2 - Rectangle gate  (axis-aligned bounding box)
//                3 - Polygon gate    (iterative ray-casting, 2-stage pipeline)
//                4 - Ellipse gate    (axis-aligned ellipse via bounding rect)
//
//              The polygon path iterates edges one at a time using a 2-stage
//              pipeline (stage 1: diff/compare, stage 2: multiply/accumulate),
//              reusing a single pair of multipliers across all edges.
//              This saves significant DSP resources compared to the parallel
//              version (2 multipliers vs 2*N).
//
//  Latency from trigger rising edge to valid output:
//    Interval / Rectangle :  1 cycle
//    Polygon (N edges)    :  N + 3 cycles  (max 15 for N=12)
//    Ellipse              :  6 cycles  (5-stage pipeline + result latch)
//
//  2026-10-27 timing rework: the 199 MHz implementation report showed this module
//  as the only failing logic (WNS -0.621 ns, 10 endpoints). Two chains were too
//  long for a 5 ns period:
//    * polygon: s1_* -> 32x32 DSP multiply -> 64-bit compare -> XOR -> crossing_acc
//    * ellipse: 132-bit add -> 132-bit compare in a single stage
//  Each was split with one extra register (polygon products, ellipse sum), which
//  costs one cycle of latency per path and nothing in throughput. Both consumers
//  qualify the result with `valid`, so the added latency is transparent.
//////////////////////////////////////////////////////////////////////////////////

module gate_judge_pipeline #(
    parameter integer C_NUM_MAX_POINTS   = 12,
    parameter integer C_POINT_DATA_WIDTH = 32
) (
    input wire  rst_n,
    input wire  sys_clk,
    input wire  enable,
    input wire  trigger,
    input wire signed [C_POINT_DATA_WIDTH-1:0] point_x,
    input wire signed [C_POINT_DATA_WIDTH-1:0] point_y,
    input wire [2:0]  gate_type,
    input wire [$clog2(C_NUM_MAX_POINTS)-1:0] gate_points_num,
    input wire [C_POINT_DATA_WIDTH * C_NUM_MAX_POINTS - 1:0] gate_points_x_pack,
    input wire [C_POINT_DATA_WIDTH * C_NUM_MAX_POINTS - 1:0] gate_points_y_pack,
    output wire valid,
    output wire result
);

    localparam CNT_WIDTH = $clog2(C_NUM_MAX_POINTS);
    localparam DW = C_POINT_DATA_WIDTH;
    localparam MW = DW * 2;                 // multiply result width

    // Gate type encoding
    localparam [2:0] GT_NO_GATE   = 3'd0,
                     GT_INTERVAL  = 3'd1,
                     GT_RECTANGLE = 3'd2,
                     GT_POLYGON   = 3'd3,
                     GT_ELLIPSE   = 3'd4,
                     GT_QUADRANT  = 3'd5,
                     GT_ALL       = 3'd6;

    // FSM states
    localparam [1:0] S_IDLE = 2'd0,
                     S_CALC = 2'd1;

    // =========================================================================
    //  Trigger rising-edge detection
    // =========================================================================
    reg trigger_dly;
    wire trigger_rise = trigger & ~trigger_dly;

    always @(posedge sys_clk or negedge rst_n)
        if (!rst_n) trigger_dly <= 1'b0;
        else        trigger_dly <= trigger;

    // =========================================================================
    //  Input latch - capture all inputs on trigger rising edge
    // =========================================================================
    reg signed [DW-1:0] px, py;
    reg [2:0]           gtype;
    reg [CNT_WIDTH-1:0] gnum;
    reg signed [DW-1:0] gx [0:C_NUM_MAX_POINTS-1];
    reg signed [DW-1:0] gy [0:C_NUM_MAX_POINTS-1];

    genvar gi;
    generate
        for (gi = 0; gi < C_NUM_MAX_POINTS; gi = gi + 1) begin : latch_pts
            always @(posedge sys_clk or negedge rst_n) begin
                if (!rst_n) begin
                    gx[gi] <= {DW{1'b0}};
                    gy[gi] <= {DW{1'b0}};
                end else if (trigger_rise) begin
                    gx[gi] <= gate_points_x_pack[gi*DW +: DW];
                    gy[gi] <= gate_points_y_pack[gi*DW +: DW];
                end
            end
        end
    endgenerate

    always @(posedge sys_clk or negedge rst_n) begin
        if (!rst_n) begin
            px    <= {DW{1'b0}};
            py    <= {DW{1'b0}};
            gtype <= 3'd0;
            gnum  <= {CNT_WIDTH{1'b0}};
        end else if (trigger_rise) begin
            px    <= point_x;
            py    <= point_y;
            gtype <= gate_type;
            gnum  <= (gate_points_num > C_NUM_MAX_POINTS[CNT_WIDTH-1:0])
                     ? C_NUM_MAX_POINTS[CNT_WIDTH-1:0] : gate_points_num;
        end
    end

    // =========================================================================
    //  Interval / Rectangle - combinational from latched values
    // =========================================================================
    wire signed [DW-1:0] bound_xmin = (gx[0] < gx[1]) ? gx[0] : gx[1];
    wire signed [DW-1:0] bound_xmax = (gx[0] < gx[1]) ? gx[1] : gx[0];
    wire signed [DW-1:0] bound_ymin = (gy[0] < gy[1]) ? gy[0] : gy[1];
    wire signed [DW-1:0] bound_ymax = (gy[0] < gy[1]) ? gy[1] : gy[0];

    wire intv_result = (px > bound_xmin) && (px < bound_xmax);
    wire rect_result = intv_result && (py > bound_ymin) && (py < bound_ymax);

    // =========================================================================
    //  Polygon - iterative 2-stage pipeline (ray-casting)
    //
    //  Stage 1 (S1): read edge vertices via mux, compute differences & skip flag.
    //                Results registered into s1_* for the next cycle.
    //  Stage 2 (S2): multiply registered operands, compare, XOR into accumulator.
    //                This multiply maps efficiently to DSP48 (inputs are registered).
    //
    //  The two stages overlap:
    //    Cycle 1:  S1(edge 0)
    //    Cycle 2:  S2(edge 0)  +  S1(edge 1)
    //    Cycle 3:  S2(edge 1)  +  S1(edge 2)
    //      ...
    //    Cycle N:  S2(edge N-2) + S1(edge N-1)
    //    Cycle N+1: S2(edge N-1)
    //    Cycle N+2: output result
    // =========================================================================

    // --- Stage 1 registers ---
    reg signed [DW-1:0] s1_a, s1_b, s1_c, s1_d;   // lhs = a*b,  rhs = c*d
    reg                 s1_skip;                     // skip this edge
    reg                 s1_y2_gt_y1;                 // direction flag
    reg                 s1_valid;                    // stage 1 output is valid

    // --- Stage 2 registers: multiplier outputs ---
    //     The 32x32 multiply used to feed the 64-bit compare in the same cycle as
    //     the DSP output; registering the products first makes each stage easy to
    //     close at 199 MHz.
    reg signed [MW-1:0] s2_lhs, s2_rhs;
    reg                 s2_skip;                     // skip this edge
    reg                 s2_y2_gt_y1;                 // direction flag
    reg                 s2_valid;                    // stage 2 output is valid

    // --- Stage 3 combinational: 64-bit compare from registered products ---
    wire poly_cross_left = s2_y2_gt_y1 ? (s2_lhs < s2_rhs)
                                       : (s2_lhs > s2_rhs);
    wire poly_crosses = ~s2_skip & ~poly_cross_left;

    // --- Polygon iteration state ---
    reg [CNT_WIDTH-1:0] edge_idx;       // current edge for stage 1
    reg                 poly_feeding;   // still feeding edges into stage 1
    reg                 crossing_acc;   // XOR accumulator (odd crossings = inside)

    // --- Vertex read (combinational from register arrays) ---
    wire [CNT_WIDTH-1:0] next_idx = (edge_idx == gnum - 1'b1)
                                    ? {CNT_WIDTH{1'b0}}
                                    : (edge_idx + 1'b1);
    wire signed [DW-1:0] vx1 = gx[edge_idx];
    wire signed [DW-1:0] vy1 = gy[edge_idx];
    wire signed [DW-1:0] vx2 = gx[next_idx];
    wire signed [DW-1:0] vy2 = gy[next_idx];

    // =========================================================================
    //  Ellipse - free-running 4-stage pipeline
    //
    //  Ellipse defined by bounding rectangle: (gx[0],gy[0]) to (gx[1],gy[1]).
    //  Test:  dx^2*sb^2 + dy^2*sa^2 <= sa^2*sb^2
    //  where  dx = 2*px-(x0+x1),  dy = 2*py-(y0+y1),
    //         sa = x1-x0,          sb = y1-y0   (all doubled semi-axes).
    //  Pure integer arithmetic, no division.
    //
    //  Stage 1: differences    Stage 2: squares
    //  Stage 3: cross products Stage 4: addition + comparison (registered)
    // =========================================================================

    // --- Stage 1: differences (registered) ---
    reg signed [DW:0] ell_dx, ell_dy, ell_sa, ell_sb;

    always @(posedge sys_clk or negedge rst_n) begin
        if (!rst_n) begin
            ell_dx <= 0;  ell_dy <= 0;
            ell_sa <= 0;  ell_sb <= 0;
        end else begin
            ell_dx <= (px <<< 1) - (gx[0] + gx[1]);
            ell_dy <= (py <<< 1) - (gy[0] + gy[1]);
            ell_sa <= gx[1] - gx[0];
            ell_sb <= gy[1] - gy[0];
        end
    end

    // --- Stage 2: squares (registered) ---
    localparam SQW = (DW + 1) * 2;
    reg signed [SQW-1:0] ell_dx2, ell_dy2, ell_sa2, ell_sb2;

    always @(posedge sys_clk or negedge rst_n) begin
        if (!rst_n) begin
            ell_dx2 <= 0;  ell_dy2 <= 0;
            ell_sa2 <= 0;  ell_sb2 <= 0;
        end else begin
            ell_dx2 <= ell_dx * ell_dx;
            ell_dy2 <= ell_dy * ell_dy;
            ell_sa2 <= ell_sa * ell_sa;
            ell_sb2 <= ell_sb * ell_sb;
        end
    end

    // --- Stage 3: cross products (registered) ---
    localparam PW = SQW * 2;
    reg signed [PW-1:0] ell_t1, ell_t2, ell_rhs;

    always @(posedge sys_clk or negedge rst_n) begin
        if (!rst_n) begin
            ell_t1 <= 0;  ell_t2 <= 0;  ell_rhs <= 0;
        end else begin
            ell_t1  <= ell_dx2 * ell_sb2;
            ell_t2  <= ell_dy2 * ell_sa2;
            ell_rhs <= ell_sa2 * ell_sb2;
        end
    end

    // --- Stage 4: sum (registered) ---
    //     The 132-bit add and the 132-bit compare were previously in one stage;
    //     splitting them costs one cycle and closes timing.
    reg signed [PW:0] ell_sum;
    reg signed [PW:0] ell_rhs_d;      // ell_rhs delayed by one cycle to stay aligned

    always @(posedge sys_clk or negedge rst_n) begin
        if (!rst_n) begin
            ell_sum   <= 0;
            ell_rhs_d <= 0;
        end else begin
            // sign-extend before adding so the 133-bit sum cannot overflow
            ell_sum   <= {ell_t1[PW-1], ell_t1} + {ell_t2[PW-1], ell_t2};
            ell_rhs_d <= {ell_rhs[PW-1], ell_rhs};
        end
    end

    // --- Stage 5: comparison (registered) ---
    reg ell_result_r;

    always @(posedge sys_clk or negedge rst_n) begin
        if (!rst_n)
            ell_result_r <= 1'b0;
        else
            ell_result_r <= (ell_sum <= ell_rhs_d);
    end

    wire ell_result = ell_result_r;

    // --- Ellipse cycle counter ---
    reg [2:0] ell_cnt;

    // =========================================================================
    //  Main FSM
    // =========================================================================
    reg [1:0] state;
    reg       result_reg;
    reg       valid_reg;

    always @(posedge sys_clk or negedge rst_n) begin
        if (!rst_n) begin
            state        <= S_IDLE;
            result_reg   <= 1'b0;
            valid_reg    <= 1'b0;
            // Polygon
            edge_idx     <= {CNT_WIDTH{1'b0}};
            crossing_acc <= 1'b0;
            s1_valid     <= 1'b0;
            s1_a <= 0;  s1_b <= 0;  s1_c <= 0;  s1_d <= 0;
            s1_skip      <= 1'b1;
            s1_y2_gt_y1  <= 1'b0;
            s2_lhs <= 0;  s2_rhs <= 0;
            s2_skip      <= 1'b1;
            s2_y2_gt_y1  <= 1'b0;
            s2_valid     <= 1'b0;
            poly_feeding <= 1'b0;
            // Ellipse
            ell_cnt      <= 3'd0;
        end else begin
            case (state)
                // ---------------------------------------------------------
                S_IDLE: begin
                    valid_reg <= 1'b0;  // auto-clear: ensure valid is a single-cycle pulse
                    if (trigger_rise) begin
                        state        <= S_CALC;
                        // Polygon init
                        edge_idx     <= {CNT_WIDTH{1'b0}};
                        crossing_acc <= 1'b0;
                        s1_valid     <= 1'b0;
                        s2_valid     <= 1'b0;   // never carry a stale edge into a new gate
                        poly_feeding <= 1'b1;
                        // Ellipse init
                        ell_cnt      <= 3'd0;
                    end
                end

                // ---------------------------------------------------------
                S_CALC: begin
                    case (gtype)
                        GT_NO_GATE: begin               // never sort when there is no gate
                            result_reg <= 1'b0;
                            valid_reg <= 1'b1;
                            state <= S_IDLE;
                        end

                        // --- Interval: 1 cycle ---
                        GT_INTERVAL: begin
                            result_reg <= intv_result;
                            valid_reg  <= 1'b1;
                            state      <= S_IDLE;
                        end

                        // --- Rectangle: 1 cycle ---
                        GT_RECTANGLE: begin
                            result_reg <= rect_result;
                            valid_reg  <= 1'b1;
                            state      <= S_IDLE;
                        end

                        // --- Polygon: iterative 2-stage pipeline ---
                        GT_POLYGON: begin
                            if (gnum < 3) begin
                                // Polygon requires at least 3 vertices
                                result_reg <= 1'b0;
                                valid_reg  <= 1'b1;
                                state      <= S_IDLE;
                            end else begin
                                // Stage 3: compare registered products, accumulate
                                if (s2_valid)
                                    crossing_acc <= crossing_acc ^ poly_crosses;

                                // Stage 2: register the products of the edge stage 1
                                // is presenting this cycle
                                s2_lhs      <= s1_a * s1_b;
                                s2_rhs      <= s1_c * s1_d;
                                s2_skip     <= s1_skip;
                                s2_y2_gt_y1 <= s1_y2_gt_y1;
                                s2_valid    <= s1_valid;

                                // Stage 1: compute diffs for current edge
                                if (poly_feeding) begin
                                    s1_a <= py  - vy1;          // py - y1
                                    s1_b <= vx2 - vx1;          // x2 - x1
                                    s1_c <= px  - vx1;          // px - x1
                                    s1_d <= vy2 - vy1;          // y2 - y1
                                    s1_skip <= (vy1 == vy2)
                                            || ((vy1 > py) == (vy2 > py));
                                    s1_y2_gt_y1 <= (vy2 > vy1);
                                    s1_valid <= 1'b1;

                                    if (edge_idx == gnum - 1'b1)
                                        poly_feeding <= 1'b0;
                                    else
                                        edge_idx <= edge_idx + 1'b1;
                                end else begin
                                    s1_valid <= 1'b0;
                                end

                                // Done: all three stages drained
                                if (!poly_feeding && !s1_valid && !s2_valid) begin
                                    result_reg <= crossing_acc;
                                    valid_reg  <= 1'b1;
                                    state      <= S_IDLE;
                                end
                            end
                        end

                        // --- Ellipse: wait for the 5-stage pipeline ---
                        GT_ELLIPSE: begin
                            ell_cnt <= ell_cnt + 1'b1;
                            if (ell_cnt == 3'd5) begin
                                result_reg <= ell_result;
                                valid_reg  <= 1'b1;
                                state      <= S_IDLE;
                            end
                        end

                        // --- All sort
                        GT_ALL: begin                   // always sort
                            result_reg <= 1'b1;
                            valid_reg <= 1'b1;
                            state <= S_IDLE;
                        end

                        // --- Unknown type: default to not-in-gate ---
                        default: begin
                            result_reg <= 1'b0;
                            valid_reg  <= 1'b1;
                            state      <= S_IDLE;
                        end
                    endcase
                end

                default: state <= S_IDLE;
            endcase
        end
    end

    // =========================================================================
    //  Output
    // =========================================================================
    assign result = result_reg;
    assign valid  = valid_reg & enable;

endmodule
