RanFang66/SeekCytometer-vivado/interfaces/ad7606c_port_v1_0.sv

// (c) Copyright 1986-2022 Xilinx, Inc. All Rights Reserved.
// (c) Copyright 2022-2026 Advanced Micro Devices, Inc. All rights reserved.
// 
// This file contains confidential and proprietary information
// of AMD and is protected under U.S. and international copyright
// and other intellectual property laws.
// 
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
// CRITICAL APPLICATIONS
// AMD products are not designed or intended to be fail-
// safe, or for use in any application requiring fail-safe
// performance, such as life-support or safety devices or
// systems, Class III medical devices, nuclear facilities,
// applications related to the deployment of airbags, or any
// other applications that could lead to death, personal
// injury, or severe property or environmental damage
// (individually and collectively, "Critical
// Applications"). Customer assumes the sole risk and
// liability of any use of AMD products in Critical
// Applications, subject only to applicable laws and
// regulations governing limitations on product liability.
// 
// THIS COPYRIGHT NOTICE AND DISCLAIMER MUST BE RETAINED AS
// PART OF THIS FILE AT ALL TIMES.
// 
// DO NOT MODIFY THIS FILE.


`ifndef ad7606c_port_v1_0
`define ad7606c_port_v1_0

interface ad7606c_port_v1_0();
  logic [15:0] ad_data;                                   // 
  logic ad_busy;                                         // 
  logic ad_first_data;                                   // 
  logic [2:0] ad_os;                                     // 
  logic ad_cs;                                           // 
  logic ad_rd;                                           // 
  logic ad_wr;                                           // 
  logic ad_reset;                                        // 
  logic ad_convstab;                                     // 

  modport MASTER (
    input ad_os, ad_cs, ad_rd, ad_wr, ad_reset, ad_convstab, 
    output ad_busy, ad_first_data, 
    inout ad_data
    );

  modport SLAVE (
    input ad_busy, ad_first_data, 
    output ad_os, ad_cs, ad_rd, ad_wr, ad_reset, ad_convstab, 
    inout ad_data
    );

  modport MONITOR (
    input ad_data, ad_busy, ad_first_data, ad_os, ad_cs, ad_rd, ad_wr, ad_reset, ad_convstab
    );

endinterface // ad7606c_port_v1_0

`endif
