RanFang66/SeekCytometer-vivado/ip_repo/ad_sample_1_0/src/ad_7606c_if.v

`timescale 1ns / 1ps
//////////////////////////////////////////////////////////////////////////////////
// AD7606C-18 Parallel Interface
//////////////////////////////////////////////////////////////////////////////////

module ad_7606c_if #(
    // ================= Timing parameters =================
    // All values are in clock cycles (200MHz clock, 5ns per cycle)
    parameter integer CONVST_LOW_CYCLES     = 8,    // 40ns (spec: >=10ns)
    parameter integer CONVST_PERIOD_CYCLES  = 71,  // 355us + 575us(busy)
    parameter integer CONVST_POST_CYCLES    = 12,   // 60ns

    parameter integer RD_LOW_CYCLES         = 6,    // 30ns (spec: >=10ns)
    parameter integer RD_CYCLE_CYCLES       = 10,   // 50ns full RD cycle
    parameter integer RD_DATA_SAMPLE        = 5,    // 25ns
    
    // Configuration write timing
    parameter integer CFG_SETUP_CYCLES      = 6,    // 30ns
    parameter integer CFG_WR_CYCLES         = 10,    // 50ns (spec: >=35ns)
    parameter integer CFG_HOLD_CYCLES       = 6     // 30ns
)(
    input              ad_clk,         // 200MHz clk
    input              rst_n,
     
    inout  [15:0]      ad_data,
    input              ad_busy,
    input              first_data,

    output [2:0]       ad_os,
    output reg         ad_cs,
    output reg         ad_rd,
    output reg         ad_wr,
    output reg         ad_reset,
    output reg         ad_convstab,
    output reg         ad_data_valid,

    output reg [17:0]  ad_ch1_val,
    output reg [17:0]  ad_ch2_val,
    output reg [17:0]  ad_ch3_val,
    output reg [17:0]  ad_ch4_val,
    output reg [17:0]  ad_ch5_val,
    output reg [17:0]  ad_ch6_val,
    output reg [17:0]  ad_ch7_val,
    output reg [17:0]  ad_ch8_val
);

assign ad_os = 3'b111;   // Software mode

wire [15:0] db_in;
reg  [15:0] db_out;
reg         db_oe; 

// ========================================================
// Read FSM states
// ========================================================
localparam S_IDLE     = 2'd0;
localparam S_READ_MSB = 2'd1;
localparam S_READ_LSB = 2'd2;
localparam S_DONE     = 2'd3;

reg [1:0]  ad_rd_state;
reg [4:0]  rd_cnt;
reg [2:0]  channel_idx;
reg [17:0] channel_buffer [0:7];
reg [2:0]  valid_hold_cnt;

// ========================================================
// Configuration WRITE FSM states
// ========================================================
localparam CFGW_IDLE   = 4'd0,
           CFGW_SETUP  = 4'd1,
           CFGW_WRLOW  = 4'd2,
           CFGW_WRHIGH = 4'd3,
           CFGW_HOLD   = 4'd4,
           CFGW_RD_PRE = 4'd5,  // release bus (db_oe=0), let chip drive
           CFGW_RD_LOW  = 4'd6,  // RD low: chip clocks register data out
           CFGW_RD_HIGH = 4'd7,  // RD high: end of read frame 
           CFGW_NEXT   = 4'd8,
           CFGW_DONE   = 4'd9;
           // ---- Extra states: complete the dummy READ frame after the
           // ---- R/W=1 command, so the chip is fully in register mode
           // ---- per datasheet "register read = two frames" definition.
           

reg [3:0] cfgw_state;
reg [5:0] cfgw_cnt;
reg [2:0] cfgw_idx;
reg       cfgw_done;

// ========================================================
// Conversion FSM states
// ========================================================
localparam S_CONV_WAIT_CONFIG = 3'd0;
localparam S_CONV_IDLE        = 3'd1;
localparam S_CONV_ASSERT      = 3'd2;
localparam S_CONV_RELEASE     = 3'd3;
localparam S_CONV_WAIT_FIRST  = 3'd4;
localparam S_CONV_WAIT_BUSY   = 3'd5;

reg [2:0]  conv_state;
reg [7:0]  conv_cnt;
reg        start_read;

// ========================================================
// IOBUF instantiation
// ========================================================
genvar i;
generate
    for (i = 0; i < 16; i = i + 1) begin : GEN_DB_IOBUF
        IOBUF u_iobuf (.I(db_out[i]), .O(db_in[i]), .T(~db_oe), .IO(ad_data[i]));
    end
endgenerate

// ========================================================
// Reset generation (5us pulse + 300us wait)
// ========================================================
reg [17:0] rst_cnt;
reg        reset_done;

always @(posedge ad_clk or negedge rst_n) begin
    if (!rst_n) begin
        rst_cnt    <= 18'd0;
        ad_reset   <= 1'b1;
        reset_done <= 1'b0;
    end else if (rst_cnt < 18'd1000) begin          // 5us reset pulse
        rst_cnt    <= rst_cnt + 1'b1;
        ad_reset   <= 1'b1;
        reset_done <= 1'b0;
    end else if (rst_cnt < 18'd61000) begin         // 300us wait (tDEVICE_SETUP=274us)
        rst_cnt    <= rst_cnt + 1'b1;
        ad_reset   <= 1'b0;
        reset_done <= 1'b0;
    end else begin
        ad_reset   <= 1'b0;
        reset_done <= 1'b1;
    end
end

// ========================================================
// Configuration data function
// Format: {R/W=0, Address[6:0], Data[7:0]} for DB17-DB2
// ========================================================
// Frame format on DB17..DB2 (= db_out[15:0]):
//   db_out[15]   = DB17 = R/W  (1 = read cmd, 0 = write cmd)
//   db_out[14:8] = DB16:DB10 = register address
//   db_out[7:0]  = DB9 :DB2  = register data (don't care for read cmd)
//
// Per datasheet (Parallel Register Mode):
//   * To write a SEQUENCE of registers, you must first exit ADC mode by
//     issuing a register READ command (WR rising edge with R/W=1). Without
//     this step, the chip stays in ADC mode and the WR pulses are NOT
//     interpreted as register writes -> some channels randomly keep their
//     reset value 0x33 (±10V single-ended).
//   * To revert back to ADC mode, drive all DBx pins low during one WR
//     cycle.
function [15:0] cfgw_word(input [2:0] idx);
    begin
        case (idx)
            // ---- Enter REGISTER MODE: dummy read of STATUS (0x01) ----
            3'd0: cfgw_word = {1'b1, 7'h01, 8'h00};
            3'd1: cfgw_word = {1'b1, 7'h01, 8'h00}; // read twice to improve stability
            // ---- Register writes ----
            // 0x03: CH1_CH2 Range, 0x11 = both ±5V single-ended
            3'd2: cfgw_word = {1'b0, 7'h03, 8'h11};
            // 0x04: CH3_CH4 Range
            3'd3: cfgw_word = {1'b0, 7'h04, 8'h11};
            // 0x05: CH5_CH6 Range
            3'd4: cfgw_word = {1'b0, 7'h05, 8'h11};
            // 0x06: CH7_CH8 Range
            3'd5: cfgw_word = {1'b0, 7'h06, 8'h11};
            // 0x07: Bandwidth = 0xFF (all channels high bandwidth)
            3'd6: cfgw_word = {1'b0, 7'h07, 8'hFF};
            // ---- Exit REGISTER MODE: WR cycle with all DBx = 0 ----
            3'd7: cfgw_word = 16'h0000;
            default: cfgw_word = 16'h0000;
        endcase
    end
endfunction

// ========================================================
// Configuration WRITE + ADC Read FSM
// ========================================================
always @(posedge ad_clk) begin
    if (!rst_n || !reset_done) begin
        cfgw_state     <= CFGW_IDLE;
        cfgw_idx       <= 3'd0;
        cfgw_cnt       <= 6'd0;
        cfgw_done      <= 1'b0;
        ad_cs          <= 1'b1;
        ad_wr          <= 1'b1;
        db_oe          <= 1'b0;
        ad_rd          <= 1'b1;

        ad_rd_state    <= S_IDLE;
        ad_data_valid  <= 1'b0;
        rd_cnt         <= 5'd0;
        channel_idx    <= 3'd0;
        valid_hold_cnt <= 3'd0;

        ad_ch1_val     <= 18'd0;
        ad_ch2_val     <= 18'd0;
        ad_ch3_val     <= 18'd0;
        ad_ch4_val     <= 18'd0;
        ad_ch5_val     <= 18'd0;
        ad_ch6_val     <= 18'd0;
        ad_ch7_val     <= 18'd0;
        ad_ch8_val     <= 18'd0;

    end else if (!cfgw_done) begin
        // ============================================
        // Configuration Write FSM
        // ============================================
        case (cfgw_state)
            CFGW_IDLE: begin
                if (ad_busy == 1'b0) begin
                    ad_cs      <= 1'b0;
                    cfgw_cnt <= 6'd0;
                    cfgw_state <= CFGW_SETUP;
                end
            end

            CFGW_SETUP: begin
                db_oe  <= 1'b1;
                db_out <= cfgw_word(cfgw_idx);
                ad_wr  <= 1'b1;
                if (cfgw_cnt == CFG_SETUP_CYCLES - 1) begin
                    cfgw_cnt   <= 6'd0;
                    cfgw_state <= CFGW_WRLOW;
                end else begin
                    cfgw_cnt <= cfgw_cnt + 1'b1;
                end
            end

            CFGW_WRLOW: begin
                ad_wr <= 1'b0;
                if (cfgw_cnt == CFG_WR_CYCLES - 1) begin
                    cfgw_cnt   <= 6'd0;
                    cfgw_state <= CFGW_WRHIGH;
                end else begin
                    cfgw_cnt <= cfgw_cnt + 1'b1;
                end
            end

            CFGW_WRHIGH: begin
                ad_wr <= 1'b1;
                cfgw_cnt <= 6'd0;
                cfgw_state <= CFGW_HOLD;
            end

            CFGW_HOLD: begin
                if (cfgw_cnt == CFG_HOLD_CYCLES - 1) begin
                    cfgw_cnt <= 6'd0;
                    // After idx==0 (the dummy READ command), perform the
                    // second frame of the read (RD pulse) to fully comply
                    // with the datasheet's "register read = two frames"
                    // definition. For all subsequent (write) frames just
                    // continue with the next register.
                    if (cfgw_idx < 3'd2)
                        cfgw_state <= CFGW_RD_PRE;
                    else
                        cfgw_state <= CFGW_NEXT;
                end else begin
                    cfgw_cnt <= cfgw_cnt + 1'b1;
                end
            end

            CFGW_RD_PRE: begin
                // Release the parallel bus so the AD7606C-18 can drive it
                // during the upcoming RD pulse. A few cycles of dead time
                // give the IOBUFs time to flip direction safely.
                db_oe <= 1'b0;
                ad_rd <= 1'b1;
                if (cfgw_cnt == CFG_SETUP_CYCLES - 1) begin
                    cfgw_cnt   <= 6'd0;
                    cfgw_state <= CFGW_RD_LOW;
                end else begin
                    cfgw_cnt <= cfgw_cnt + 1'b1;
                end
            end

            CFGW_RD_LOW: begin
                ad_rd <= 1'b0;
                if (cfgw_cnt == RD_LOW_CYCLES - 1) begin
                    cfgw_cnt   <= 6'd0;
                    cfgw_state <= CFGW_RD_HIGH;
                end else begin
                    cfgw_cnt <= cfgw_cnt + 1'b1;
                end
            end

            CFGW_RD_HIGH: begin
                ad_rd <= 1'b1;
                cfgw_cnt <= 6'd0;
                cfgw_state <= CFGW_NEXT;
                // db_in (register content) is intentionally discarded.
                // if (cfgw_cnt == CFG_HOLD_CYCLES - 1) begin
                //     cfgw_cnt   <= 6'd0;
                //     cfgw_state <= CFGW_NEXT;
                // end else begin
                //     cfgw_cnt <= cfgw_cnt + 1'b1;
                // end
            end

            CFGW_NEXT: begin
                // idx 0     : enter register mode (dummy read cmd)
                // idx 1..5  : actual register writes
                // idx 6     : exit register mode (DBx all zero WR cycle)
                ad_cs <= 1'b1;
                if (cfgw_cnt == 6'd2) begin
                    cfgw_cnt <= 6'd0;
                    ad_cs <= 1'b0;

                    if (cfgw_idx == 3'd7) begin
                        cfgw_state <= CFGW_DONE;
                    end else begin
                        cfgw_idx <= cfgw_idx + 1;
                        cfgw_state <= CFGW_SETUP;
                    end
                end else begin
                    cfgw_cnt <= cfgw_cnt + 1;
                end


                // if (cfgw_idx == 3'd6)
                //     cfgw_state <= CFGW_DONE;
                // else begin
                //     cfgw_idx   <= cfgw_idx + 1'b1;
                //     cfgw_state <= CFGW_SETUP;
                // end
            end

            CFGW_DONE: begin
                ad_cs     <= 1'b1;
                db_oe     <= 1'b0;
                cfgw_done <= 1'b1;
            end
        endcase
        
    end else begin
        // ============================================
        // ADC Read FSM (after config done)
        // ============================================
        case (ad_rd_state)
            S_IDLE: begin
                ad_data_valid <= 1'b0;
                if (start_read) begin
                    ad_cs          <= 1'b0;
                    ad_rd          <= 1'b0;
                    rd_cnt         <= 5'd0;
                    channel_idx    <= 3'd0;
                    valid_hold_cnt <= 3'd0;
                    ad_rd_state    <= S_READ_MSB;
                end 
            end

            S_READ_MSB: begin
                case (rd_cnt)
                    5'd0: begin
                        ad_rd  <= 1'b0;
                        rd_cnt <= rd_cnt + 1'b1;
                    end
                    RD_DATA_SAMPLE: begin
                        // Sample high 16 bits (DB17-DB2 = ADC[17:2])
                        channel_buffer[channel_idx][17:2] <= db_in;
                        rd_cnt <= rd_cnt + 1'b1;
                    end
                    RD_LOW_CYCLES: begin
                        ad_rd  <= 1'b1;
                        rd_cnt <= rd_cnt + 1'b1;
                    end
                    RD_CYCLE_CYCLES: begin
                        rd_cnt      <= 5'd0;
                        ad_rd_state <= S_READ_LSB;
                    end
                    default: begin
                        rd_cnt <= rd_cnt + 1'b1;
                    end
                endcase
            end
            
            S_READ_LSB: begin
                case (rd_cnt)
                    5'd0: begin
                        ad_rd  <= 1'b0;
                        rd_cnt <= rd_cnt + 1'b1;
                    end
                    RD_DATA_SAMPLE: begin
                        // Sample low 2 bits
                        // DB17/DB1 pin -> ad_data[15] -> ADC Bit 1
                        // DB16/DB0 pin -> ad_data[14] -> ADC Bit 0
                        channel_buffer[channel_idx][1] <= db_in[15];
                        channel_buffer[channel_idx][0] <= db_in[14];
                        rd_cnt <= rd_cnt + 1'b1;
                    end
                    RD_LOW_CYCLES: begin
                        ad_rd  <= 1'b1;
                        rd_cnt <= rd_cnt + 1'b1;
                    end
                    RD_CYCLE_CYCLES: begin
                        if (channel_idx == 3'd7) begin
                            ad_rd_state <= S_DONE;
                            rd_cnt      <= 5'd0;
                        end else begin
                            channel_idx <= channel_idx + 1'b1;
                            rd_cnt      <= 5'd0;
                            ad_rd_state <= S_READ_MSB;
                        end
                    end
                    default: begin
                        rd_cnt <= rd_cnt + 1'b1;
                    end
                endcase
            end

            S_DONE: begin
                if (valid_hold_cnt == 3'd0) begin
                    ad_cs <= 1'b1;
                    ad_rd <= 1'b1;

                    ad_ch1_val <= channel_buffer[0];
                    ad_ch2_val <= channel_buffer[1];
                    ad_ch3_val <= channel_buffer[2];
                    ad_ch4_val <= channel_buffer[3];
                    ad_ch5_val <= channel_buffer[4];
                    ad_ch6_val <= channel_buffer[5];
                    ad_ch7_val <= channel_buffer[6];
                    ad_ch8_val <= channel_buffer[7];

                    ad_data_valid  <= 1'b1;
                    valid_hold_cnt <= 3'd1;
                end
                else if (valid_hold_cnt == 3'd4) begin
                    ad_data_valid <= 1'b0;
                    ad_rd_state   <= S_IDLE;
                end
                else begin
                    valid_hold_cnt <= valid_hold_cnt + 1'b1;
                end
            end

            default: ad_rd_state <= S_IDLE;
        endcase
    end
end

// ========================================================
// Conversion FSM (Independent - Pipeline with Read FSM)
// ========================================================
always @(posedge ad_clk) begin
    if (!rst_n || !reset_done) begin
        ad_convstab <= 1'b1;
        conv_state  <= S_CONV_WAIT_CONFIG;
        conv_cnt    <= 8'd0;
        start_read  <= 1'b0;
    end else begin
        case (conv_state)
            S_CONV_WAIT_CONFIG: begin
                ad_convstab <= 1'b1;
                start_read  <= 1'b0;
                if (cfgw_done) begin
                    conv_state <= S_CONV_IDLE;
                    conv_cnt   <= 8'd0;
                end
            end

            S_CONV_IDLE: begin
                ad_convstab <= 1'b1;
                start_read  <= 1'b0;
                if (conv_cnt == CONVST_PERIOD_CYCLES - 1) begin
                    conv_cnt   <= 8'd0;
                    conv_state <= S_CONV_ASSERT;
                end else begin
                    conv_cnt <= conv_cnt + 1'b1;
                end
            end

            S_CONV_ASSERT: begin
                ad_convstab <= 1'b0;
                if (conv_cnt == CONVST_LOW_CYCLES - 1) begin
                    conv_cnt   <= 8'd0;
                    conv_state <= S_CONV_RELEASE;
                end else begin
                    conv_cnt <= conv_cnt + 1'b1;
                end
            end

            S_CONV_RELEASE: begin
                ad_convstab <= 1'b1;
                if (conv_cnt == CONVST_POST_CYCLES - 1) begin
                    conv_cnt   <= 8'd0;
                    conv_state <= S_CONV_WAIT_FIRST;
                end else begin
                    conv_cnt <= conv_cnt + 1'b1;
                end
            end

            S_CONV_WAIT_FIRST: begin
                // Brief wait to ensure BUSY has risen
                if (conv_cnt == 8'd20) begin
                    conv_state <= S_CONV_WAIT_BUSY;
                    conv_cnt   <= 8'd0;
                end else begin
                    conv_cnt <= conv_cnt + 1'b1;
                end
            end

            S_CONV_WAIT_BUSY: begin
                if (!ad_busy) begin
                    start_read <= 1'b1;
                    conv_cnt   <= 8'd0;
                    conv_state <= S_CONV_IDLE;
                end else begin
                    start_read <= 1'b0;
                end
            end
            
            default: conv_state <= S_CONV_WAIT_CONFIG;
        endcase
    end
end

endmodule
