RanFang66/SeekCytometer-vivado/(commit log)

2026-01-28 Initial commit: seek_cytometer Zynq UltraScale+ project
    工程内容:
    - 自定义接口: interfaces/
    - 自定义IP核: ip_repo/ad_sample_1_0, ip_repo/signal_analyzer_1_0
    - Vivado工程: seek_cytometer/
    - Block Design: cytometer_platform
2026-03-10 add time delay calcution feature and fix bugs
    [ad_7606c_if.v, drive_signal_generation.v, event_aggregator.v, signal_analyzer_v1_0_S00_AXI.v]
2026-04-02 fix bug and and sort all gate
    [time_table.csv]
2026-04-03 fix time constraints problem
    [gate_judge_pipeline.v]
2026-04-07 fix ad7606c configuration bugs
    [ad_7606c_if.v]
2026-04-15 add sort delay refer feature and fix drive delay bug
    [drive_signal_generation.v, signal_analyzer_v1_0_S00_AXI.v]
2026-06-04 重构 Vivado 工程管理：源码与工程分离，杜绝 -force 删源码
    问题根因：自动导出的 create_project.tcl 会生成
    `create_project seek_cytometer ./seek_cytometer`，把新工程建到提交在 git
    里的源码目录（含 seek_cytometer.srcs）。该目录非空 → 需 -force，而
    create_project -force 会先删除整个目标目录，从而抹掉源码；且每次
    write_project_tcl 重新导出都会复发此问题。
    改为「工程即一次性产物」的管理方式：
    - 新增手写、稳定的 scripts/build.tcl 作为构建入口（工程生成到 build/，
    自定位 info script，与工作目录无关，-force 仅作用于一次性的 build/）
    - 删除自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
    [ad7606.xdc, debug_core.xdc]
2026-10-14 feat: 信号基线自动识别与基线校正（阶段1，度量级）
    - 新增 baseline_estimator.v：双相 EMA 基线估计器（ACQUIRE 快速收敛 / TRACK 慢速跟踪），Q18.6 定点，含看门狗与斜率二级门控（阶段1 禁用）
    - pulse_analyzer.v：脉冲结束时对 peak/area 做度量级基线修正（peak-baseline、area-baseline*width）
    - signal_analyzer_v1_0_S00_AXI.v：实例化 8 路 baseline_estimator，新增 slv_reg2/42/43 基线寄存器及回读 MUX
    - drive_signal_generation.v / S00_AXI.v：纯净模式整体删除（sort_abort、slv_reg55 残留清理）
    - doc：新增基线设计方案与代码 review 报告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
2026-10-14 feat: 检测级基线化（阶段2，相对阈值 + 门控接线）
    - pulse_analyzer.v：新增 baseline_valid 端口与 detect_ref 相对阈值，baseline_valid=0 时退回绝对阈值；上升/下降沿判断由 sample>threshold 改为 sample>(baseline+threshold)
    - signal_analyzer_v1_0_S00_AXI.v：pulse_analyzer 补接 baseline_valid；baseline_estimator 的 pulse_active 由 1'b0 改为真实信号，使主门控/守门/看门狗生效（slope_th 仍禁用）
2026-10-15 docs: 新增信号基线开发记录小结
    记录基线功能的提交、实现进度、寄存器映射、阈值语义变化与调试要点，便于后续追踪与调试
2026-10-22 feat: 阶段3收尾 — baseline_en 门控、slv_reg3 运行时化、slv_reg43 只读
    - baseline_estimator.v: acquire_len/guard_len/max_pulse_wid 编译期参数转端口，
    计数器宽度固定 16/8/8 bit，新增 acquire_len=0 防挂死守卫
    - S00_AXI: slv_reg2[0] baseline_en 门控 pulse_analyzer 输入（默认关闭=回退绝对阈值）；
    slv_reg3 复位默认 0xFF080400 并接端口；slv_reg43 写路径删除改只读
    - 开发记录小结: 阶段3 完成状态、寄存器表与待办更新
2026-10-22 docs: 新增信号基线识别与校正上机调试测试 SOP
    覆盖阶段3已交付功能的板级验证：ACQUIRE/TRACK 收敛、相对阈值、
    baseline_en 门控、运行时参数、寄存器回读；含 ILA 配置、7 个用例、
    判定标准与已知坑排查。
2026-10-23 baseline: widen max_pulse_wid to 16-bit, alpha_shift to 5-bit
    - max_pulse_wid / wid_cnt [7:0] -> [15:0]
    - alpha_shift driven from slv_reg2[6:2]
    - max_pulse_wid driven from slv_reg4[15:0]; slv_reg3 reset drops it,
    slv_reg4 reset to 255
    - clamp TRACK ema_shift to 24 (avoids >>> sign-fill for alpha >= 25)
2026-10-25 fix: ad_data_filter 求和溢出导致基线跳变，并重写上机调试 SOP
    ad_data_filter 对 4 个 18-bit 样本求和未显式符号扩展，悬空输入
    (~1.5V ≈ +39300 码 > 32768) 时中间 + 按 18-bit 运算回绕为负数，
    滤波输出错误，基线大范围跳变。修复：求和前逐操作数 $signed 符号
    扩展到 SUM_WIDTH(20-bit)。
    同步重写上机调试 SOP：接入阶段4 UDP/HMI 基线调试台为测试主入口，
    修正寄存器表(max_pulse_wid 迁移 slv_reg4[15:0])，新增悬空稳定性回归用例。
2026-10-26 fix(baseline): pipeline EMA estimator to fix baseline jump on floating channels
    The raw waveform is stable but the baseline keeps jumping. Logic review
    shows the EMA math is correct, so the remaining cause is a timing
    violation in the estimator's single-cycle feedback path:
    baseline -> subtract(err) -> 5-level barrel shift -> add -> baseline
    at 199 MHz (and the alpha_shift 3->5 bit widening added 2 more barrel
    levels). Latch err into err_reg so the subtract and the shift+add are
    split across two clock cycles. Behavior-preserving for a slow EMA
    (2-cycle feedback delay is negligible at alpha=2^-10).
    Also MARK_DEBUG sample_in and err_reg for ILA localization.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
2026-10-27 fix(timing): 拆分 gate_judge 的乘法与比较链路，收敛 199 MHz 时序
    实现报告显示设计未满足时序：WNS -0.621 ns、10 个失败端点，全部落在
    gate_wrapper/u_gate_judge，也就是本模块两条「乘加 + 比较挤在一拍」的链路。
    bitstream 虽然照常生成，但这是必须修的硬伤。
    - 多边形：32x32 DSP 乘法结果先寄存进 s2_lhs/s2_rhs（新增 S2 级），
    64 位比较 + XOR 移到下一级（S3）
    - 椭圆：132 位加法与 132 位比较原本在同一级，现在加法寄存进 ell_sum
    （新增 S4 级），比较放到下一级；ell_rhs 打一拍对齐（ell_rhs_d）
    - 状态机 ell_cnt 判据 4 → 5；多边形排空条件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
2026-10-27 fix(baseline): 用符号-幅值移位重写估计器，修掉基线爬满量程
    根因：`{baseline[23], baseline} + (err_reg >>> k)` 中，负的 err_reg 被按
    逻辑右移处理（实测行为），一个 -29770 的误差变成 +2^24 量级的正数，基线每拍
    向上跳 |err|/2^k，几拍就冲到 +FS 并被定点饱和钉住。
    ILA 证据：err_reg 为负（0x1E2F15C = -29770），baseline 却在上升，且每步
    ≈ |err|/2^k。这一个根因先后伪装成：valid 恒 No、基线卡在 131071、
    每 4 拍锯齿跳变、ACQUIRE 永远出不来、Re-acquire 无效。
    改动：
    - baseline_estimator.v 重写为极简实现（约 50 行）：单极点非对称 IIR，
    采样低于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
2026-10-27 feat(baseline-diag): 构建标识与内部状态回读，便于上板定位
    上板调试最大的成本是「看不到内部到底在做什么」，这次为此补了只读观测：
    - slv_reg44[31:24] = 0xA7 构建标识：一眼分辨板上是不是最新镜像
    （此前曾在旧 bitstream 上排查多轮而不自知）
    - slv_reg44[17:10] = 8 通道 FSM 状态位，[9] = overflow_any
    - slv_reg55 @ 0x37：[31:14] 监控通道原始滤波采样，[13:0] 采样节拍（÷256。
    200 kSPS 时每次 500 ms 轮询约 +390，几 Hz 时几乎不动）
    - 0x3F：ACQUIRE 进度计数（判断状态机有没有在走）
    - baseline_estimator 增加 bypass 输入（slv_reg2[14]），用于写通路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
2026-10-27 docs(baseline): 新增 Debug 复盘文档，更新开发记录
    - 新增《信号基线Debug复盘与工程经验》：根因（`>>>` 符号语义）、十轮上板
    时间线、同一 bug 伪装成六种故障的映射表、诊断手段性价比排序、七条反面
    教训、下次的 Checklist
    - 开发记录小结：补充 2026-10-26/27 的两次定点溢出修复与 gate_judge 时序
    修复；更新寄存器映射与参数默认值（alpha_shift=16、acquire_len=1024；
    guard_len / max_pulse_wid / slope_th 已废弃）及现场实测数据
2026-10-28 feat(baseline): Max Pulse Width 由空接改为"电平跟随时限"
    极简估计器（快降 2^-4 / 慢升 2^-alpha）没有脉宽门控，slv_reg4 一直是空接的，
    把它开放给用户之前必须给它一个真实语义。
    - 新增 level_cnt: 连续多少个采样没有出现"低于基线"的样本。
    - 超过 max_pulse_wid 时判定为电平整体抬升（气泡/堵塞/前级漂移），
    慢升腿临时提速 2^-16 -> 2^-6，让估计跟上真实电平。
    - max_pulse_wid = 0 表示关闭该功能。
    - 对脉冲串安全：1 kHz 脉冲每个周期都有采样落到底部（200 kSPS 下周期仅约
    200 个采样），计数器每周期被清零，永远到不了默认的 4095；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
2026-10-28 refactor(pl): 移除上板调试诊断回读；状态字改为导出使能通道掩码
    基线功能验证完成后，清掉为定位故障临时加的全部观测点：
    - 删除 slv_reg55(0x37) 诊断（采样节拍 + 监控通道原始采样）
    - 删除 0x3F 的 ACQUIRE 进度计数
    - 删除 slv_reg44[17:10] 逐通道状态位、估计器的 dbg_state/dbg_acq_cnt 端口
    - 删除采样节拍预分频计数器
    - 0x37 / 0x3F 恢复为普通寄存器读（这两个地址本来就没有写寄存器，
    注意 slv_reg43/slv_reg55 从未声明，不能按地址数字反推寄存器名）
    - slv_reg44 保留构建标识 0xA7 与 [9]overflow/[8]analyze_en/[7:0]pulse_active，
    新增 [23:16] = slv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
2026-10-28 docs(baseline): 更新寄存器语义、参数默认值与用户使用说明
    - 寄存器表: max_pulse_wid 由"看门狗门限"改为"电平跟随时限"；slv_reg44 增补
    [23:16] 使能通道掩码；标注 0x37/0x3F 诊断已移除、逐通道状态位已移除
    - 参数表: alpha_shift=16、max_pulse_wid=4095，guard_len/slope_th/pulse_active
    标注为不再使用
    - 新增"面向用户的使用方式"一节: 参数入口（Cytometer 面板 Baseline 分组）、
    持久化与自动重下发、两个观察入口（波形虚线参考线 + 分组底部数值）、
    售后排查仍走 Engineer 菜单
